aderhol/Clock_Synchronization/Interface/Hardware/measurements/PPS delay/50 Ohm driver/board#1/PPS feedback/pictures/P1140020.JPG

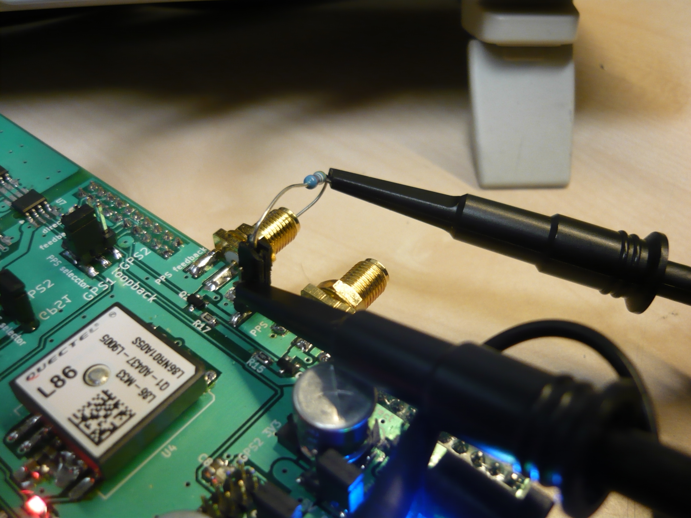
Interface/Hardware/measurements/PPS delay/50 Ohm driver/board#1/PPS feedback/pictures/P1140020.JPG
