aderhol/Clock_Synchronization/Interface/Hardware/BOM/BOM_Farnell.pdf

Date: | October 7, 2017
Component Count: | 6
Amount | Designation | Value | Package | Farnell | Datasheet
2 | isolator | ISO7421E | SOIC-8 | 2496656 http://www.ti.com/lit/ds/symlink/iso7421e.pdf
2 | RS-485 driver | SN65LBC179A | SOIC-8 | 1102962 http://www.ti.com/lit/ds/symlink/sn65lbc179a.pdf
1 | DC/DC converter NXJ1S0505MC | SMD | 2518531 http://power.murata.com/data/power/ncl/kdc_nxj1.pdf
1 | 8P8C connector | shield | SMD | 2533494 https://www.amphenolcanada.com/PDFjs/web/Viewer.html?file=../../ProductSearch/Drawings/AC/RJCSE538001.pdf
