aderhol/Clock_Synchronization/Interface/Hardware/Assembly/assembly record.xlsx

Sheet: card #1
reference | designation | value | date of mounting | note | auxiliary
C1 | capacitor | 0.1u | 2017-11-15
C2 | capacitor | 1000u | 2017-11-15
C3 | capacitor | 0.47u | 2017-11-14
C4 | capacitor | 22u | 2017-11-14
C5 | capacitor | 1000u | 2017-11-14
C8 | capacitor | 1u | 2017-11-14
C9 | capacitor | 0.1u | 2017-11-15
C10 | capacitor | 0.01u | 2017-11-15
C11 | capacitor | 1u | 2017-11-15
C12 | capacitor | 0.1u | 2017-11-15
C13 | capacitor | 0.1u | 2017-11-15
C14 | capacitor | 1u | 2017-11-15
C15 | capacitor | 10u | 2017-11-15
C16 | capacitor | 4.7u | 2017-11-14
C17 | capacitor | 0.1u | 2017-11-14
C18 | capacitor | 0.1u | 2017-11-14
C19 | capacitor | 0.1u | 2017-11-14
C20 | capacitor | 0.1u | 2017-11-14
C21 | capacitor | 2.2u | 2017-11-14
C22 | capacitor | 0.1u | 2017-11-14
C23 | capacitor | 0.1u | 2017-11-14
D1 | LED | blue | 2017-11-14 | direct
D2 | LED | blue | 2017-11-14 | feedback
D3 | LED | green | 2017-11-14 | line Tx
D4 | LED | yellow | 2017-11-14 | line Rx
D5 | LED | green | 2017-11-14 | GPS1 Tx
D6 | LED | yellow | 2017-11-14 | GPS1 Rx
D7 | LED | green | 2017-11-14 | GPS2 Tx
D8 | LED | yellow | 2017-11-14 | GPS2 Rx
D9 | Schottky diode | 1A - 20V | 2017-11-14
D10 | Schottky diode | 1A - 20V | 2017-11-14
D11 | zener diode | 24V | 2017-11-14
D12 | LED | blue | 2017-11-14 | 5V
D13 | LED | red | 2017-11-14 | 3V3
D14 | LED | red | 2017-11-14 | GPS2 3V3
D15 | LED | red | 2017-11-14 | GPS1 3V3
D16 | zener diode | 5V1 | 2017-11-14
D17 | LED | blue | 2017-11-14 | 5V
J1 | molex connector | 4-pin | 2017-11-15 | I2C
J2 | molex connector | 4-pin | 2017-11-15 | line UART
J3 | molex connector | 4-pin | 2017-11-15 | GPS2 UART
J4 | molex connector | 4-pin | 2017-11-15 | GPS1 UART
J5 | pin header | 2P | 2017-11-14 | PPS direct probe point
J6 | pin header | 3P x 2 | 2017-11-15 | PPS selecctor
J7 | pin header | 2P | 2017-11-14 | PPS feedback probe point
J8 | pin header | 10P x 2 | 2017-11-14 | left bottom connector
J9 | pin header | 10P x 2 | 2017-11-14 | right bottom connector
J10 | power connector | barrel jack | 2017-11-14
J11 | pin header | 2P | 2017-11-14 | PWR probe point
J12 | pin header | 2P | 2017-11-14 | 5V probe point
J13 | pin header | 4P x 2 | 2017-11-15 | GPS2 connector
J14 | SMA connector |  | 2017-11-15 | PPS direct
J15 | SMA connector |  | 2017-11-15 | PPS feedback
J16 | pin header | 2P | 2017-11-14 | DC/DC in probe point
J17 | pin header | 2P | 2017-11-14 | 5V isolated
J18 | modular jack | 8P8C | 2017-11-15 | RJ45
J19 | pin header | 10P x 2 | 2017-11-14 | left top connector
J20 | pin header | 10P x 2 | 2017-11-14 | right top connector
JP1 | pin header | 3P | 2017-11-15 | GPS selector
JP2 | pin header | 2P | 2017-11-14 | 5V out measurement point
JP3 | pin header | 2P | 2017-11-14 | 3v3 in measurement point
JP4 | resistor | 0 | 2017-11-15 | A0
JP5 | resistor | 0 | 2017-11-15 | A1
JP6 | pin header | 2P | 2017-11-14 | 5V in measurement point
JP7 | pin header | 3P | 2017-11-15 | GPS2 ant pwr
JP8 | pin header | 2P | 2017-11-14 | 5V isolated measurement point
JP9 | pin header | 2P | 2017-11-14 | DC/DC in measurement point
L1 | inductance | 4.7u | 2017-11-14
L2 | inductance | 10u | 2017-11-14
Q1 | pnp transistor | BSV52LT1G | 2017-11-15
Q2 | pnp transistor | BSV52LT1G | 2017-11-15
R1 | resistor | 2k | 2017-11-14
R2 | resistor | 2k | 2017-11-14
R3 | resistor | 390 | 2017-11-14
R4 | resistor | 390 | 2017-11-14
R5 | resistor | 10k | 2017-11-15
R6 | resistor | 2k | 2017-11-14
R7 | resistor | 10k | 2017-11-15
R8 | resistor | 2k | 2017-11-14
R9 | resistor | 10k | 2017-11-15
R10 | resistor | 2k | 2017-11-14
R11 | resistor | 2k | 2017-11-14
R12 | resistor | 1k5 | 2017-11-14
R13 | resistor | 1k5 | 2017-11-14
R14 | resistor | 1k5 | 2017-11-14
R15 | resistor | 50 | 2017-11-15
R16 | resistor | inf |  |  | X
R17 | resistor | 50 | 2017-11-15
R18 | resistor | inf |  |  | X
R19 | resistor | 0 - ??? | 2017-11-14 | 0
R20 | resistor | 100 | 2017-11-15
R21 | resistor | 100 | 2017-11-15
R22 | resistor | 2k | 2017-11-14
U1 | transistor array | ULN2003A | 2017-11-15
U2 | temperature sensor | LM92 | 2017-11-15
U3 | LDO regulator | LM2940S-5.0 | 2017-11-14
U4 | GPS | L86 | 2017-11-15 | GPS1
U5 | DC/DC converter | NXJ1S0505MC | 2017-11-14
U6 | digital isolator | ISO7421E | 2017-11-14
U7 | digital isolator | ISO7421E | 2017-11-14
U8 | RS-485 transceiver | SN65LBC179A | 2017-11-14
U9 | RS-485 transceiver | SN65LBC179A | 2017-11-14

Sheet: card #2
reference | designation | value | date of mounting | note | auxiliary
C1 | capacitor | 0.1u | 2017-11-17
C2 | capacitor | 1000u | 2017-11-17
C3 | capacitor | 0.47u | 2017-11-17
C4 | capacitor | 22u | 2017-11-17
C5 | capacitor | 1000u | 2017-11-17
C8 | capacitor | 1u | 2017-11-17
C9 | capacitor | 0.1u | 2017-11-16
C10 | capacitor | 0.01u | 2017-11-16
C11 | capacitor | 1u | 2017-11-16
C12 | capacitor | 0.1u | 2017-11-16
C13 | capacitor | 0.1u | 2017-11-21
C14 | capacitor | 1u | 2017-11-21
C15 | capacitor | 10u | 2027-11-21
C16 | capacitor | 4.7u | 2017-11-17
C17 | capacitor | 0.1u | 2017-11-17
C18 | capacitor | 0.1u | 2017-11-17
C19 | capacitor | 0.1u | 2017-11-17
C20 | capacitor | 0.1u | 2017-11-17
C21 | capacitor | 2.2u | 2017-11-17
C22 | capacitor | 0.1u | 2017-11-17
C23 | capacitor | 0.1u | 2017-11-17
D1 | LED | blue | 2017-11-17 | direct
D2 | LED | blue | 2017-11-17 | feedback
D3 | LED | green | 2017-11-17 | line Tx
D4 | LED | yellow | 2017-11-17 | line Rx
D5 | LED | green | 2017-11-17 | GPS1 Tx
D6 | LED | yellow | 2017-11-17 | GPS1 Rx
D7 | LED | green | 2017-11-17 | GPS2 Tx
D8 | LED | yellow | 2017-11-17 | GPS2 Rx
D9 | Schottky diode | 1A - 20V | 2017-11-17
D10 | Schottky diode | 1A - 20V | 2017-11-17
D11 | zener diode | 24V | 2017-11-17
D12 | LED | blue | 2017-11-17 | 5V
D13 | LED | red | 2017-11-17 | 3V3
D14 | LED | red | 2017-11-17 | GPS2 3V3
D15 | LED | red | 2017-11-21 | GPS1 3V3
D16 | zener diode | 5V1 | 2017-11-17
D17 | LED | blue | 2017-11-17 | 5V
J1 | molex connector | 4-pin | 2017-11-17 | I2C
J2 | molex connector | 4-pin | 2017-11-21 | line UART
J3 | molex connector | 4-pin | 2017-11-17 | GPS2 UART
J4 | molex connector | 4-pin | 2017-11-21 | GPS1 UART
J5 | pin header | 2P | 2017-11-17 | PPS direct probe point
J6 | pin header | 3P x 2 | 2017-11-17 | PPS selecctor
J7 | pin header | 2P | 2017-11-21 | PPS feedback probe point
J8 | pin header | 10P x 2 | 2017-11-17 | left bottom connector
J9 | pin header | 10P x 2 | 2017-11-17 | right bottom connector
J10 | power connector | barrel jack | 2017-11-17
J11 | pin header | 2P | 2017-11-17 | PWR probe point
J12 | pin header | 2P | 2017-11-17 | 5V probe point
J13 | pin header | 4P x 2 | 2017-11-17 | GPS2 connector
J14 | SMA connector |  | 2017-11-17 | PPS direct
J15 | SMA connector |  | 2017-11-21 | PPS feedback
J16 | pin header | 2P | 2017-11-17 | DC/DC in probe point
J17 | pin header | 2P | 2017-11-17 | 5V isolated
J18 | modular jack | 8P8C | 2017-11-17 | RJ45
J19 | pin header | 10P x 2 | 2017-11-17 | left top connector
J20 | pin header | 10P x 2 | 2017-11-17 | right top connector
JP1 | pin header | 3P | 2017-11-17 | GPS selector
JP2 | pin header | 2P | 2017-11-17 | 5V out measurement point
JP3 | pin header | 2P | 2017-11-17 | 3v3 in measurement point
JP4 | resistor | 0 | 2017-11-17 | A0
JP5 | resistor | 0 | 2017-11-17 | A1
JP6 | pin header | 2P | 2017-11-17 | 5V in measurement point
JP7 | pin header | 3P | 2017-11-17 | GPS2 ant pwr
JP8 | pin header | 2P | 2017-11-17 | 5V isolated measurement point
JP9 | pin header | 2P | 2017-11-17 | DC/DC in measurement point
L1 | inductance | 4.7u | 2017-11-17
L2 | inductance | 10u | 2017-11-17
Q1 | pnp transistor | BSV52LT1G | 2017-11-17
Q2 | pnp transistor | BSV52LT1G | 2017-11-21
R1 | resistor | 2k | 2017-11-17
R2 | resistor | 2k | 2017-11-17
R3 | resistor | 390 | 2017-11-17
R4 | resistor | 390 | 2017-11-17
R5 | resistor | 10k | 2017-11-16
R6 | resistor | 2k | 2017-11-16
R7 | resistor | 10k | 2017-11-16
R8 | resistor | 2k | 2017-11-16
R9 | resistor | 10k | 2017-11-16
R10 | resistor | 2k | 2017-11-16
R11 | resistor | 2k | 2017-11-16
R12 | resistor | 1k5 | 2017-11-17
R13 | resistor | 1k5 | 2017-11-16
R14 | resistor | 1k5 | 2017-11-17
R15 | resistor | 50 | 2017-11-17
R16 | resistor | inf |  |  | X
R17 | resistor | 50 | 2017-11-21 | 47ohm
R18 | resistor | inf |  |  | X
R19 | resistor | 0 - ??? | 2017-11-17 | 0
R20 | resistor | 100 | 2017-11-17
R21 | resistor | 100 | 2017-11-17
R22 | resistor | 2k | 2017-11-17
U1 | transistor array | ULN2003A | 2017-11-16
U2 | temperature sensor | LM92 | 2017-11-17
U3 | LDO regulator | LM2940S-5.0 | 2017-11-17
U4 | GPS | L86 | 2017-11-21 | GPS1
U5 | DC/DC converter | NXJ1S0505MC | 2017-11-17
U6 | digital isolator | ISO7421E | 2017-11-17
U7 | digital isolator | ISO7421E | 2017-11-17
U8 | RS-485 transceiver | SN65LBC179A | 2017-11-17
U9 | RS-485 transceiver | SN65LBC179A | 2017-11-17
