aderhol/Clock_Synchronization/Interface/Hardware/RS-422 Options/RS-422 interface options.xlsx

Sheet: transceivers
part number | isolated | temperature range | supply voltage | driver propagation delay typical | driver propagation delay maximum | receiver propagation delay typical | receiver propagation delay maximum | maximum driver propagation delay deviance over -40 °C to 85 °C | maximum receiver propagation delay deviance over -40 °C to 85°C | propagation delay asymmetry based on the typical values | price
ISO3086T | yes | -40 °C to +85 °C | 5V (3.3V) | 25 ns | 45 ns | 103 ns | 125 ns | 5.5 ns | 3.25 ns | 78 ns | 2659 Ft
SN65LBC179A | no | -40 °C to +85 °C | 5V | 6 ns | 12 ns | 13 ns | 20 ns | 1.0 ns | 0.53 ns | 7 ns | 897 Ft
ADM2582E | yes | -40 °C to +85 °C | 5V | 64 ns | 100 ns | 95 ns | 110 ns | 11.0 ns | NDA | 31 ns | 4495 Ft
LTM2881 | yes | -40 °C to +85 °C | 3.3V/5V | 60 ns | 85 ns | 100 ns | 140 ns | 6.0 ns | 10.0 ns | 40 ns | 4758 Ft
MAX14855 | yes | -40 °C to +105 °C | 3.3V/5V | 45 ns | 65 ns | 40 ns | 65 ns | 9.0 ns | 6.0 ns | 5 ns | 1685 Ft
ISO35T | yes | -40 °C to +85 °C | 3.3V | 205 ns | 340 ns | 85 ns | 115 ns | 28.0 ns | 20.0 ns | 120 ns | 2461 Ft
ISO35 | yes | -40 °C to +85 °C | 3.3V | NDA | 340 ns | NDA | 100 ns | NDA | NDA | NDA | 2461 Ft

Sheet: compact
part number | quantity | driver propagation delay typical | driver propagation delay maximum | receiver propagation delay typical | receiver propagation delay maximum | maximum driver propagation delay deviance over -40 °C to 85 °C | maximum receiver propagation delay deviance over -40 °C to 85°C | propagation delay asymmetry based on the typical values | price
ISO3086T | 2 pcs | 25 ns | 45 ns | 103 ns | 125 ns | 5.5 ns | 3.25 ns | 78 ns | 2659 Ft
DA2303-AL | 1 pcs |  |  |  |  |  |  |  | 809 Ft
TPS76350 | 1 pcs |  |  |  |  |  |  |  | 260 Ft
10 µF | 2 pcs |  |  |  |  |  |  |  | 50 Ft
4.7 µF | 1 pcs |  |  |  |  |  |  |  | 26 Ft
Schottky diode | 2 pcs |  |  |  |  |  |  |  | 17 Ft
0.1 µF | 5 pcs |  |  |  |  |  |  |  | 3 Ft
7 types | 14 pcs | 25 ns | 45 ns | 103 ns | 125 ns | 5.5 ns | 3.25 ns | 78 ns | 6562 Ft

Sheet: separate
part number | quantity | driver propagation delay typical | driver propagation delay maximum | receiver propagation delay typical | receiver propagation delay maximum | maximum driver propagation delay deviance over -40 °C to 85 °C | maximum receiver propagation delay deviance over -40 °C to 85°C | propagation delay asymmetry based on the typical values | price
SN65LBC179A | 2 pcs | 6 ns | 12 ns | 13 ns | 20 ns | 1.0 ns | 0.53 ns | 7 ns | 897 Ft
ISO7421E | 2 pcs | 7 ns | 11 ns | 7 ns | 11 ns | 0.75 ns | 0.75 ns | 0 ns | 1310 Ft
NXJ1S0505MC | 1 pcs |  |  |  |  |  |  |  | 897 Ft
LBR2518T100K | 1 pcs |  |  |  |  |  |  |  | 62 Ft
2.2 µF | 1 pcs |  |  |  |  |  |  |  | 27 Ft
CVH252009-4R7M | 1 pcs |  |  |  |  |  |  |  | 75 Ft
4.7 µF | 1 pcs |  |  |  |  |  |  |  | 26 Ft
0.1 µF | 6 pcs |  |  |  |  |  |  |  | 3 Ft
8 types | 15 pcs | 13 ns | 23 ns | 20 ns | 31 ns | 1.75 ns | 1.27 ns | 7 ns | 5519 Ft
