aderhol/Clock_Synchronization/Interface/Hardware/measurements/PPS delay/board-to-board/117cm/loopback/II/NOTE.txt

PPS direct: outgoing PPS from the module
PPS received: incoming PPS on the other module
PPS feedback: incoming PPS from the other module on the module which generates the PPS
