aderhol/Clock_Synchronization/Interface/Hardware/measurements/PPS delay/board-to-board/117cm/loopback/I/scope.CSV

Model | DPO2012
Firmware Version | 1.56
Point Format | Y
Horizontal Units | S
Horizontal Scale | 1e-05
Sample Interval | 1e-09
Filter Frequency | 1e+08
Record Length | 100000
Gating | 0.0% to 100.0% | 0.0% to 100.0%
Probe Attenuation | 10 | 10
Vertical Units | V | V
Vertical Offset | 0 | 0
Vertical Scale | 1 | 1
Label | PPS direct | PPS feedback
TIME | CH1 | CH2
-4.99580e-05 | 0.04 | 0.06
-4.99570e-05 | 0.04 | 0.06
-4.99560e-05 | 0.08 | 0.02
-4.99550e-05 | 0.08 | 0.02
-4.99540e-05 | 0.08 | 0.02
-4.99530e-05 | 0.04 | 0.02
-4.99520e-05 | 0.04 | 0.02
-4.99510e-05 | 0.04 | 0.06
-4.99500e-05 | 0.08 | 0.06
-4.99490e-05 | 0.08 | 0.1
-4.99480e-05 | 0.08 | 0.1
-4.99470e-05 | 0.08 | 0.06
-4.99460e-05 | 0.08 | 0.02
-4.99450e-05 | 0.08 | 0.02
-4.99440e-05 | 0.08 | 0.02
-4.99430e-05 | 0.04 | 0.02
-4.99420e-05 | 0.04 | 0.02
-4.99410e-05 | 0.04 | 0.02
-4.99400e-05 | 0.04 | 0.02
-4.99390e-05 | 0.04 | 0.06
-4.99380e-05 | 0.08 | 0.06
-4.99370e-05 | 0.08 | 0.1
-4.99360e-05 | 0.08 | 0.06
-4.99350e-05 | 0.08 | 0.02
-4.99340e-05 | 0.08 | 0.02
-4.99330e-05 | 0.04 | 0.02
-4.99320e-05 | 0.04 | -0.02
-4.99310e-05 | 0.04 | 0.02
-4.99300e-05 | 0.04 | 0.02
-4.99290e-05 | 0.04 | 0.06
-4.99280e-05 | 0.08 | 0.06
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
