aderhol/Clock_Synchronization/Interface/Hardware/measurements/PPS delay/board-to-board/MIT 03.104-03.105/board-to-board/sender-to-receiver/PicoScope waveforms/PicoScope_01.csv

Time | Channel A | Channel B
(ns) | (V) | (V)
-51.54300531 | 0.00153789 | -0.00030758
-51.29300531 | 0.00369095 | -0.00338337
-51.04300532 | 0.00476747 | -0.00891978
-50.79300533 | 0.00538263 | -0.01599409
-50.54300534 | 0.00538263 | -0.02352977
-50.29300534 | 0.00476747 | -0.03060408
-50.04300535 | 0.00353716 | -0.03598671
-49.79300536 | 0.00138410 | -0.03890871
-49.54300536 | -0.00169168 | -0.03890871
-49.29300537 | -0.00584400 | -0.03598671
-49.04300538 | -0.01107283 | -0.03060408
-48.79300539 | -0.01676304 | -0.02352977
-48.54300539 | -0.02276083 | -0.01599409
-48.29300540 | -0.02845103 | -0.00891978
-48.04300541 | -0.03352608 | -0.00338337
-47.79300541 | -0.03752461 | -0.00030758
-47.54300542 | -0.04060039 | -0.00030758
-47.29300543 | -0.04229207 | -0.00338337
-47.04300543 | -0.04290723 | -0.00891978
-46.79300544 | -0.04259966 | -0.01599409
-46.54300545 | -0.04183071 | -0.02352977
-46.29300546 | -0.04075418 | -0.03060408
-46.04300546 | -0.03983144 | -0.03583292
-45.79300547 | -0.03937008 | -0.03875492
-45.54300548 | -0.03921629 | -0.03890871
-45.29300548 | -0.03921629 | -0.03660187
-45.04300549 | -0.03937008 | -0.03183440
-44.79300550 | -0.03952387 | -0.02583661
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
