aderhol/Clock_Synchronization/Interface/Hardware/measurements/PPS delay/board-to-board/MIT 03.104-03.105/board-to-board/sender-to-receiver/PicoScope waveforms/PicoScope_02.csv

Time | Channel A | Channel B
(ns) | (V) | (V)
-50.27534231 | 0.00000000 | 0.00153789
-50.02534231 | 0.00046137 | 0.00369095
-49.77534232 | 0.00123032 | 0.00476747
-49.52534233 | 0.00230684 | 0.00538263
-49.27534234 | 0.00307579 | 0.00538263
-49.02534234 | 0.00338337 | 0.00476747
-48.77534235 | 0.00292200 | 0.00369095
-48.52534236 | 0.00138410 | 0.00153789
-48.27534236 | -0.00169168 | -0.00184547
-48.02534237 | -0.00584400 | -0.00645915
-47.77534238 | -0.01091904 | -0.01230315
-47.52534239 | -0.01676304 | -0.01906988
-47.27534239 | -0.02276083 | -0.02583661
-47.02534240 | -0.02845103 | -0.03183440
-46.77534241 | -0.03352608 | -0.03660187
-46.52534241 | -0.03752461 | -0.03890871
-46.27534242 | -0.04060039 | -0.03875492
-46.02534243 | -0.04229207 | -0.03583292
-45.77534243 | -0.04290723 | -0.03060408
-45.52534244 | -0.04259966 | -0.02352977
-45.27534245 | -0.04183071 | -0.01599409
-45.02534246 | -0.04075418 | -0.00891978
-44.77534246 | -0.03983144 | -0.00338337
-44.52534247 | -0.03921629 | -0.00030758
-44.27534248 | -0.03921629 | -0.00030758
-44.02534248 | -0.03983144 | -0.00338337
-43.77534249 | -0.04075418 | -0.00891978
-43.52534250 | -0.04183071 | -0.01599409
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
