aderhol/Clock_Synchronization/Interface/Hardware/measurements/PPS delay/board-to-board/MIT 03.104-03.105/board-to-board/sender-to-receiver/PicoScope waveforms/PicoScope_03.csv

Time | Channel A | Channel B
(ns) | (V) | (V)
-51.15078131 | 0.00000000 | 0.00000000
-50.90078131 | 0.00000000 | 0.00000000
-50.65078132 | 0.00000000 | 0.00000000
-50.40078133 | 0.00000000 | 0.00000000
-50.15078134 | 0.00000000 | 0.00000000
-49.90078134 | 0.00000000 | 0.00000000
-49.65078135 | 0.00000000 | 0.00000000
-49.40078136 | 0.00000000 | 0.00000000
-49.15078136 | 0.00000000 | 0.00000000
-48.90078137 | 0.00000000 | 0.00000000
-48.65078138 | 0.00000000 | 0.00000000
-48.40078139 | 0.00000000 | 0.00000000
-48.15078139 | 0.00000000 | 0.00000000
-47.90078140 | 0.00000000 | 0.00000000
-47.65078141 | 0.00000000 | 0.00000000
-47.40078141 | 0.00000000 | 0.00000000
-47.15078142 | 0.00000000 | 0.00000000
-46.90078143 | 0.00000000 | 0.00000000
-46.65078143 | 0.00000000 | 0.00000000
-46.40078144 | 0.00000000 | 0.00000000
-46.15078145 | 0.00000000 | 0.00000000
-45.90078146 | 0.00000000 | 0.00000000
-45.65078146 | 0.00000000 | 0.00000000
-45.40078147 | 0.00000000 | 0.00000000
-45.15078148 | 0.00000000 | 0.00000000
-44.90078148 | 0.00000000 | 0.00000000
-44.65078149 | 0.00000000 | 0.00000000
-44.40078150 | 0.00000000 | 0.00000000
-44.15078151 | 0.00000000 | 0.00000000
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
