aderhol/Clock_Synchronization/Interface/Hardware/measurements/PPS delay/board-to-board/MIT 03.104-03.105/board-to-board/sender-to-receiver/PicoScope waveforms/PicoScope_04.csv

Time | Channel A | Channel B
(ns) | (V) | (V)
-51.70739431 | 0.00000000 | -0.00046137
-51.45739431 | 0.00000000 | -0.00338337
-51.20739432 | 0.00000000 | -0.00891978
-50.95739433 | 0.00000000 | -0.01599409
-50.70739434 | 0.00000000 | -0.02352977
-50.45739434 | 0.00000000 | -0.03060408
-50.20739435 | 0.00000000 | -0.03598671
-49.95739436 | 0.00000000 | -0.03890871
-49.70739436 | 0.00000000 | -0.03890871
-49.45739437 | 0.00000000 | -0.03598671
-49.20739438 | 0.00000000 | -0.03060408
-48.95739439 | 0.00000000 | -0.02352977
-48.70739439 | 0.00000000 | -0.01599409
-48.45739440 | 0.00000000 | -0.00891978
-48.20739441 | -0.00015379 | -0.00338337
-47.95739441 | 0.00000000 | -0.00030758
-47.70739442 | 0.00015379 | -0.00030758
-47.45739443 | 0.00061516 | -0.00338337
-47.20739443 | 0.00138410 | -0.00891978
-46.95739444 | 0.00230684 | -0.01599409
-46.70739445 | 0.00307579 | -0.02352977
-46.45739446 | 0.00353716 | -0.03060408
-46.20739446 | 0.00307579 | -0.03583292
-45.95739447 | 0.00138410 | -0.03875492
-45.70739448 | -0.00169168 | -0.03890871
-45.45739448 | -0.00645915 | -0.03660187
-45.20739449 | -0.01230315 | -0.03183440
-44.95739450 | -0.01906988 | -0.02583661
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
