aderhol/Clock_Synchronization/Interface/Hardware/measurements/PPS delay/board-to-board/MIT 03.104-03.105/board-to-board/sender-to-receiver/PicoScope waveforms/PicoScope_05.csv

Time | Channel A | Channel B
(ns) | (V) | (V)
-51.53545431 | 0.00000000 | -0.03890871
-51.28545431 | 0.00000000 | -0.03660187
-51.03545432 | 0.00000000 | -0.03183440
-50.78545433 | 0.00000000 | -0.02583661
-50.53545434 | 0.00000000 | -0.01906988
-50.28545434 | 0.00000000 | -0.01230315
-50.03545435 | 0.00000000 | -0.00645915
-49.78545436 | 0.00000000 | -0.00169168
-49.53545436 | 0.00000000 | 0.00138410
-49.28545437 | 0.00000000 | 0.00307579
-49.03545438 | 0.00000000 | 0.00353716
-48.78545439 | 0.00000000 | 0.00307579
-48.53545439 | 0.00000000 | 0.00230684
-48.28545440 | 0.00000000 | 0.00138410
-48.03545441 | 0.00000000 | 0.00061516
-47.78545441 | 0.00000000 | 0.00015379
-47.53545442 | 0.00000000 | 0.00000000
-47.28545443 | 0.00000000 | -0.00015379
-47.03545443 | 0.00000000 | 0.00000000
-46.78545444 | 0.00000000 | 0.00000000
-46.53545445 | 0.00000000 | 0.00000000
-46.28545446 | 0.00000000 | 0.00000000
-46.03545446 | 0.00000000 | 0.00000000
-45.78545447 | 0.00000000 | 0.00000000
-45.53545448 | 0.00000000 | 0.00000000
-45.28545448 | 0.00000000 | 0.00000000
-45.03545449 | 0.00000000 | 0.00000000
-44.78545450 | 0.00000000 | 0.00000000
-44.53545451 | 0.00000000 | 0.00000000
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
