aderhol/Clock_Synchronization/Interface/Hardware/measurements/PPS delay/board-to-board/MIT 03.104-03.105/board-to-board/sender-to-receiver/PicoScope waveforms/PicoScope_06.csv

Time | Channel A | Channel B
(ns) | (V) | (V)
-50.99566831 | 0.00000000 | -0.03890871
-50.74566831 | -0.00015379 | -0.03598671
-50.49566832 | 0.00000000 | -0.03060408
-50.24566833 | 0.00000000 | -0.02352977
-49.99566834 | 0.00000000 | -0.01599409
-49.74566834 | 0.00000000 | -0.00891978
-49.49566835 | 0.00000000 | -0.00338337
-49.24566836 | 0.00000000 | -0.00030758
-48.99566836 | 0.00000000 | -0.00030758
-48.74566837 | 0.00000000 | -0.00338337
-48.49566838 | 0.00000000 | -0.00891978
-48.24566839 | 0.00000000 | -0.01599409
-47.99566839 | 0.00000000 | -0.02352977
-47.74566840 | 0.00000000 | -0.03060408
-47.49566841 | -0.00015379 | -0.03598671
-47.24566841 | 0.00000000 | -0.03890871
-46.99566842 | 0.00015379 | -0.03890871
-46.74566843 | 0.00061516 | -0.03598671
-46.49566843 | 0.00138410 | -0.03060408
-46.24566844 | 0.00230684 | -0.02352977
-45.99566845 | 0.00307579 | -0.01599409
-45.74566846 | 0.00353716 | -0.00891978
-45.49566846 | 0.00307579 | -0.00338337
-45.24566847 | 0.00138410 | -0.00030758
-44.99566848 | -0.00169168 | -0.00030758
-44.74566848 | -0.00645915 | -0.00338337
-44.49566849 | -0.01230315 | -0.00891978
-44.24566850 | -0.01906988 | -0.01599409
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
