aderhol/Clock_Synchronization/Interface/Hardware/measurements/PPS delay/cable loopback/scope.CSV

Model | DPO2012
Firmware Version | 1.56
Point Format | Y
Horizontal Units | S
Horizontal Scale | 1e-05
Sample Interval | 1e-09
Filter Frequency | 1e+08
Record Length | 100000
Gating | 0.0% to 100.0% | 0.0% to 100.0%
Probe Attenuation | 10 | 10
Vertical Units | V | V
Vertical Offset | 0 | 0
Vertical Scale | 1 | 1
Label | PPS direct | PPS feedback
TIME | CH1 | CH2
-4.99800e-05 | 0.12 | 0.02
-4.99790e-05 | 0.08 | 0.06
-4.99780e-05 | 0.08 | 0.02
-4.99770e-05 | 0.04 | 0.02
-4.99760e-05 | 0.04 | 0.02
-4.99750e-05 | 0 | 0.02
-4.99740e-05 | 0.04 | 0.02
-4.99730e-05 | 0.04 | 0.06
-4.99720e-05 | 0.12 | 0.06
-4.99710e-05 | 0.12 | 0.06
-4.99700e-05 | 0.12 | 0.06
-4.99690e-05 | 0.08 | 0.06
-4.99680e-05 | 0.04 | 0.06
-4.99670e-05 | 0 | 0.02
-4.99660e-05 | 0 | 0.02
-4.99650e-05 | 0 | 0.02
-4.99640e-05 | 0.04 | 0.02
-4.99630e-05 | 0.08 | 0.06
-4.99620e-05 | 0.12 | 0.06
-4.99610e-05 | 0.12 | 0.06
-4.99600e-05 | 0.12 | 0.06
-4.99590e-05 | 0.08 | 0.1
-4.99580e-05 | 0.04 | 0.02
-4.99570e-05 | 0 | 0.02
-4.99560e-05 | 0 | 0.02
-4.99550e-05 | 0 | 0.02
-4.99540e-05 | 0.04 | 0.02
-4.99530e-05 | 0.08 | 0.02
-4.99520e-05 | 0.12 | 0.02
-4.99510e-05 | 0.12 | 0.06
-4.99500e-05 | 0.12 | 0.06
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
