aderhol/Clock_Synchronization/Interface/Hardware/measurements/PPS delay/50 Ohm driver/board#1/PPS feedback/T0000ALL.CSV

Model | DPO2012
Firmware Version | 1.56
Point Format | Y
Horizontal Units | S
Horizontal Scale | 1e-05
Sample Interval | 1e-09
Filter Frequency | 1e+08
Record Length | 100000
Gating | 0.0% to 100.0% | 0.0% to 100.0%
Probe Attenuation | 10 | 10
Vertical Units | V | V
Vertical Offset | 0 | 0
Vertical Scale | 0.5 | 0.5
Label | PPS feedback | 50 \x11
TIME | CH1 | CH2
-4.99880e-05 | 0.02 | 0.00999999
-4.99870e-05 | 0.02 | 0.00999999
-4.99860e-05 | 0.04 | 0.00999999
-4.99850e-05 | 0.04 | 0.03
-4.99840e-05 | 0.06 | 0.03
-4.99830e-05 | 0.04 | 0.03
-4.99820e-05 | 0.06 | 0.03
-4.99810e-05 | 0.02 | 0.05
-4.99800e-05 | 0.02 | 0.03
-4.99790e-05 | 0 | 0.03
-4.99780e-05 | 0 | 0.00999999
-4.99770e-05 | -0.02 | 0.00999999
-4.99760e-05 | 0 | 0.00999999
-4.99750e-05 | 0.02 | 0.00999999
-4.99740e-05 | 0.06 | 0.00999999
-4.99730e-05 | 0.06 | 0.00999999
-4.99720e-05 | 0.06 | 0.00999999
-4.99710e-05 | 0.04 | 0.05
-4.99700e-05 | 0.02 | 0.03
-4.99690e-05 | 0 | 0.03
-4.99680e-05 | 0.02 | 0.00999999
-4.99670e-05 | -0.02 | 0.03
-4.99660e-05 | 0.02 | -0.01
-4.99650e-05 | 0.04 | 0.00999999
-4.99640e-05 | 0.06 | 0.00999999
-4.99630e-05 | 0.04 | 0.03
-4.99620e-05 | 0.04 | 0.03
-4.99610e-05 | 0.02 | 0.03
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
