aderhol/Clock_Synchronization/Interface/Hardware/measurements/PPS delay/board-to-board/1100cm/loopback/scope.CSV

Model | DPO2012
Firmware Version | 1.56
Point Format | Y
Horizontal Units | S
Horizontal Scale | 1e-05
Sample Interval | 1e-09
Filter Frequency | 1e+08
Record Length | 100000
Gating | 0.0% to 100.0% | 0.0% to 100.0%
Probe Attenuation | 10 | 10
Vertical Units | V | V
Vertical Offset | 0 | 0
Vertical Scale | 1 | 1
Label | PPS board#1 | PPS board#2
TIME | CH1 | CH2
-4.99076e-05 | 0.08 | 0.06
-4.99066e-05 | 0.08 | 0.06
-4.99056e-05 | 0.08 | 0.06
-4.99046e-05 | 0.08 | 0.06
-4.99036e-05 | 0.08 | 0.02
-4.99026e-05 | 0.08 | -0.02
-4.99016e-05 | 0.08 | -0.02
-4.99006e-05 | 0.04 | -0.02
-4.98996e-05 | 0.04 | -0.02
-4.98986e-05 | 0.04 | 0.06
-4.98976e-05 | 0.08 | 0.06
-4.98966e-05 | 0.08 | 0.1
-4.98956e-05 | 0.12 | 0.1
-4.98946e-05 | 0.12 | 0.06
-4.98936e-05 | 0.12 | 0.02
-4.98926e-05 | 0.08 | 0.02
-4.98916e-05 | 0.04 | -0.02
-4.98906e-05 | 0.04 | -0.02
-4.98896e-05 | 0.04 | -0.02
-4.98886e-05 | 0.04 | 0.02
-4.98876e-05 | 0.04 | 0.06
-4.98866e-05 | 0.08 | 0.1
-4.98856e-05 | 0.12 | 0.1
-4.98846e-05 | 0.12 | 0.06
-4.98836e-05 | 0.12 | 0.06
-4.98826e-05 | 0.08 | 0.02
-4.98816e-05 | 0.04 | -0.02
-4.98806e-05 | 0 | -0.06
-4.98796e-05 | 0 | -0.02
-4.98786e-05 | 0.04 | 0.02
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
