aderhol/Clock_Synchronization/Interface/Hardware/measurements/PPS delay/board-to-board/1100cm/board-to-board/sender-to-receiver/scope.CSV

Model | DPO2012
Firmware Version | 1.56
Point Format | Y
Horizontal Units | S
Horizontal Scale | 1e-05
Sample Interval | 1e-09
Filter Frequency | 1e+08
Record Length | 100000
Gating | 0.0% to 100.0% | 0.0% to 100.0%
Probe Attenuation | 10 | 10
Vertical Units | V | V
Vertical Offset | 0 | 0
Vertical Scale | 1 | 1
Label | PPS board#1 | PPS board#2
TIME | CH1 | CH2
-4.99534e-05 | 0.08 | 0.02
-4.99524e-05 | 0.04 | 0.02
-4.99514e-05 | 0.04 | 0.02
-4.99504e-05 | 0.04 | 0.02
-4.99494e-05 | 0.04 | 0.06
-4.99484e-05 | 0.04 | 0.06
-4.99474e-05 | 0.08 | 0.06
-4.99464e-05 | 0.08 | 0.06
-4.99454e-05 | 0.12 | 0.02
-4.99444e-05 | 0.08 | 0.02
-4.99434e-05 | 0.08 | -0.02
-4.99424e-05 | 0 | -0.02
-4.99414e-05 | 0 | -0.06
-4.99404e-05 | 0 | -0.02
-4.99394e-05 | 0.04 | 0.02
-4.99384e-05 | 0.08 | 0.06
-4.99374e-05 | 0.08 | 0.1
-4.99364e-05 | 0.12 | 0.1
-4.99354e-05 | 0.12 | 0.1
-4.99344e-05 | 0.12 | 0.06
-4.99334e-05 | 0.08 | -0.02
-4.99324e-05 | 0.04 | -0.06
-4.99314e-05 | 0.04 | -0.06
-4.99304e-05 | 0.04 | -0.02
-4.99294e-05 | 0.04 | 0.02
-4.99284e-05 | 0.08 | 0.1
-4.99274e-05 | 0.08 | 0.1
-4.99264e-05 | 0.08 | 0.1
-4.99254e-05 | 0.08 | 0.1
-4.99244e-05 | 0.08 | 0.06
-4.99234e-05 | 0.04 | -0.02
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
