aderhol/Clock_Synchronization/Interface/Hardware/measurements/PPS delay/board-to-board/117cm/board-to-board/sender-to-receiver/scope.CSV

Model | DPO2012
Firmware Version | 1.56
Point Format | Y
Horizontal Units | S
Horizontal Scale | 1e-05
Sample Interval | 1e-09
Filter Frequency | 1e+08
Record Length | 100000
Gating | 0.0% to 100.0% | 0.0% to 100.0%
Probe Attenuation | 10 | 10
Vertical Units | V | V
Vertical Offset | 0 | 0
Vertical Scale | 1 | 1
Label | PPS board#1 | PPS board#2
TIME | CH1 | CH2
-4.99778e-05 | 0.08 | 0.06
-4.99768e-05 | 0.04 | 0.06
-4.99758e-05 | 0.08 | 0.06
-4.99748e-05 | 0.08 | 0.1
-4.99738e-05 | 0.08 | 0.02
-4.99728e-05 | 0.04 | 0.02
-4.99718e-05 | 0.08 | -0.02
-4.99708e-05 | 0.04 | 0.02
-4.99698e-05 | 0.08 | 0.02
-4.99688e-05 | 0.04 | 0.06
-4.99678e-05 | 0.08 | 0.06
-4.99668e-05 | 0.04 | 0.1
-4.99658e-05 | 0.08 | 0.06
-4.99648e-05 | 0.04 | 0.02
-4.99638e-05 | 0.04 | 0.02
-4.99628e-05 | 0.04 | 0.02
-4.99618e-05 | 0.04 | 0.02
-4.99608e-05 | 0.04 | 0.02
-4.99598e-05 | 0.08 | 0.02
-4.99588e-05 | 0.08 | 0.06
-4.99578e-05 | 0.08 | 0.06
-4.99568e-05 | 0.04 | 0.06
-4.99558e-05 | 0.08 | 0.02
-4.99548e-05 | 0.04 | 0.06
-4.99538e-05 | 0.04 | 0.02
-4.99528e-05 | 0.04 | 0.02
-4.99518e-05 | 0.04 | -0.02
-4.99508e-05 | 0.04 | 0.02
-4.99498e-05 | 0.08 | 0.02
-4.99488e-05 | 0.04 | 0.06
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
