aderhol/Clock_Synchronization/Interface/Hardware/measurements/PPS delay/50 Ohm driver/board#1/PPS direct/pictures/P1140017.JPG

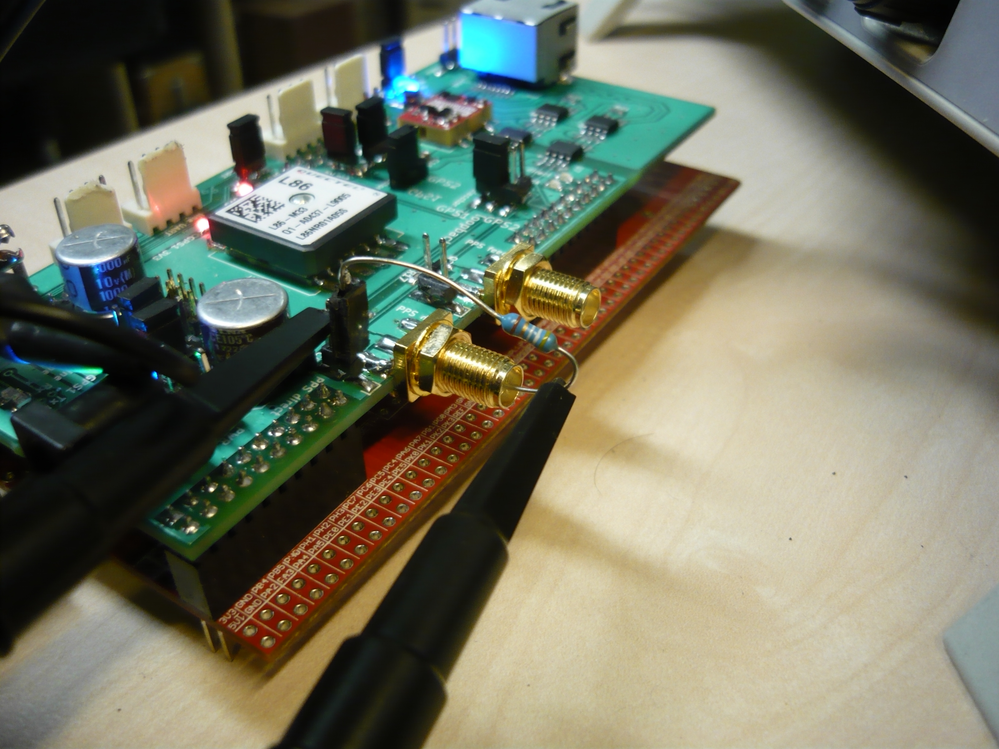
Interface/Hardware/measurements/PPS delay/50 Ohm driver/board#1/PPS direct/pictures/P1140017.JPG
