aderhol/Clock_Synchronization/Interface/Hardware/measurements/PPS delay/50 Ohm driver/board#1/PPS direct/tek00000.PNG

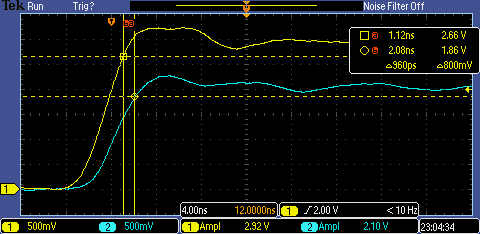
Interface/Hardware/measurements/PPS delay/50 Ohm driver/board#1/PPS direct/tek00000.PNG
