aderhol/Clock_Synchronization/Interface/Hardware/measurements/PPS delay/50 Ohm driver/board#2/PPS direct/pictures/P1140024.JPG

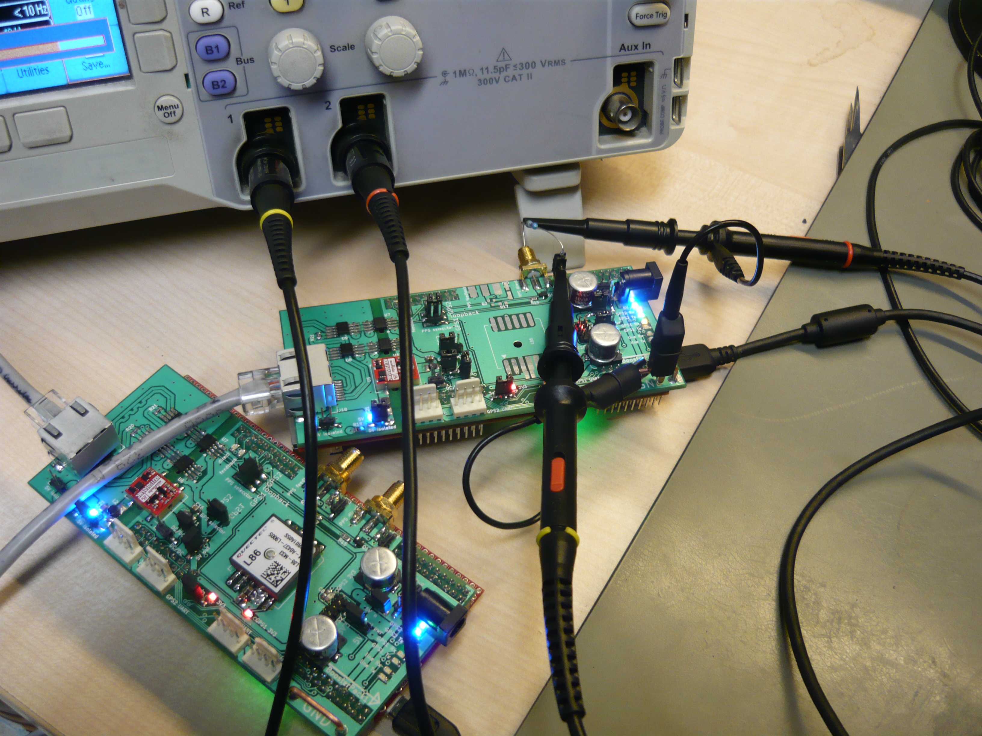
Interface/Hardware/measurements/PPS delay/50 Ohm driver/board#2/PPS direct/pictures/P1140024.JPG
