aderhol/Clock_Synchronization/Interface/Hardware/measurements/PPS delay/50 Ohm driver/board#2/PPS feedback/pictures/P1140066.JPG

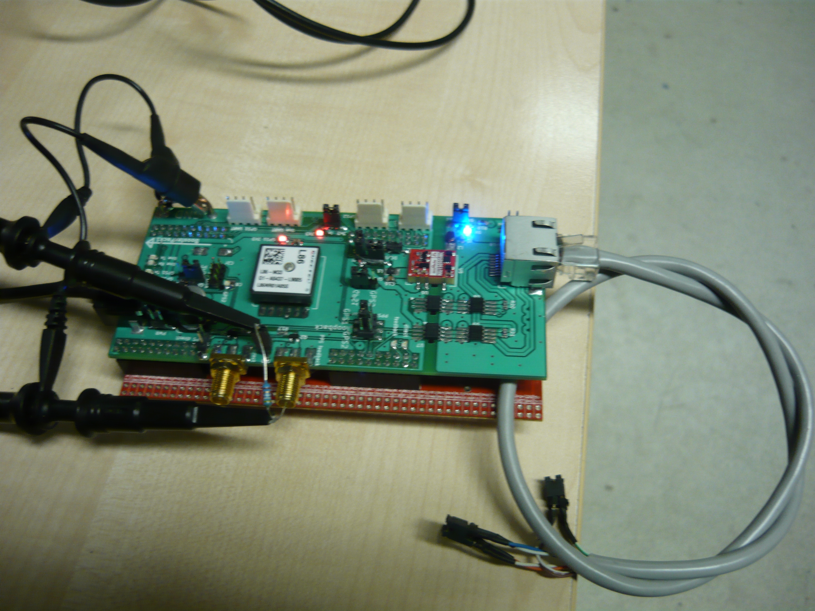
Interface/Hardware/measurements/PPS delay/50 Ohm driver/board#2/PPS feedback/pictures/P1140066.JPG
