aderhol/Clock_Synchronization/Interface/Hardware/measurements/PPS delay/50 Ohm driver/board#2/PPS feedback/TEK00000.PNG

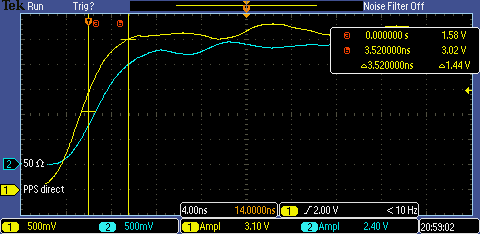
Interface/Hardware/measurements/PPS delay/50 Ohm driver/board#2/PPS feedback/TEK00000.PNG
