aderhol/Clock_Synchronization/Interface/Hardware/measurements/PPS delay/board-to-board/117cm/loopback/I/pictures/P1140004.JPG

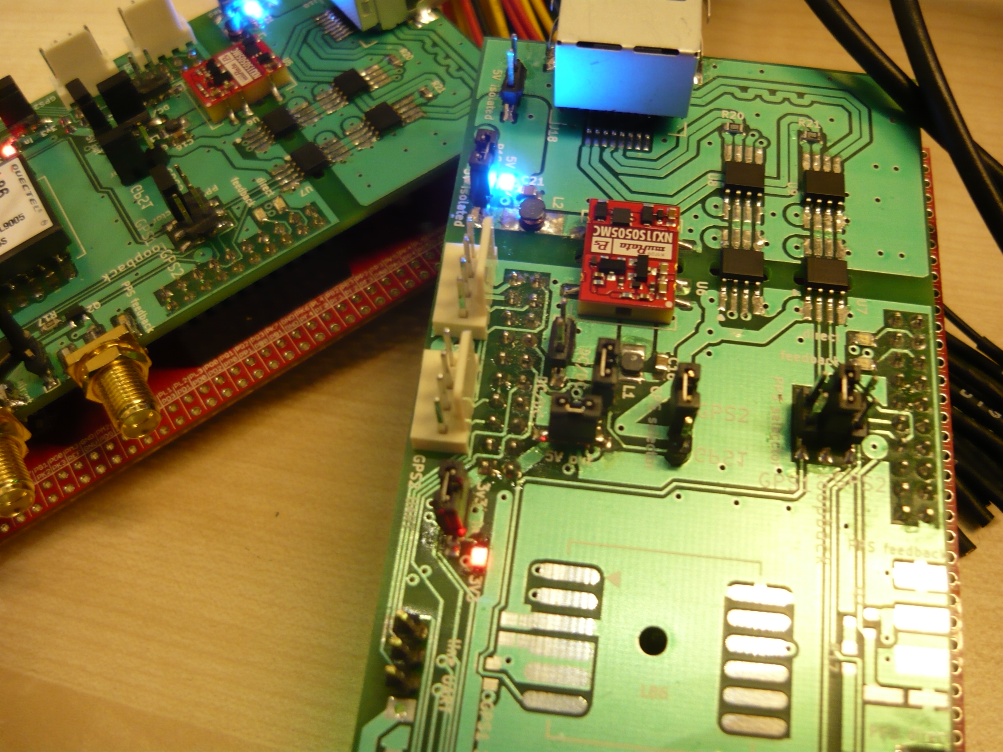
Interface/Hardware/measurements/PPS delay/board-to-board/117cm/loopback/I/pictures/P1140004.JPG
