aderhol/Clock_Synchronization/Interface/Hardware/measurements/PPS delay/board-to-board/117cm/loopback/I/scope.PNG

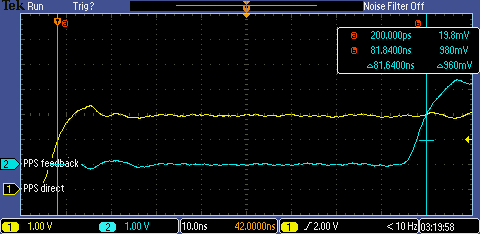
Interface/Hardware/measurements/PPS delay/board-to-board/117cm/loopback/I/scope.PNG
