aderhol/Clock_Synchronization/Interface/Hardware/measurements/PPS delay/board-to-board/117cm/loopback/I/VirtualBench.png

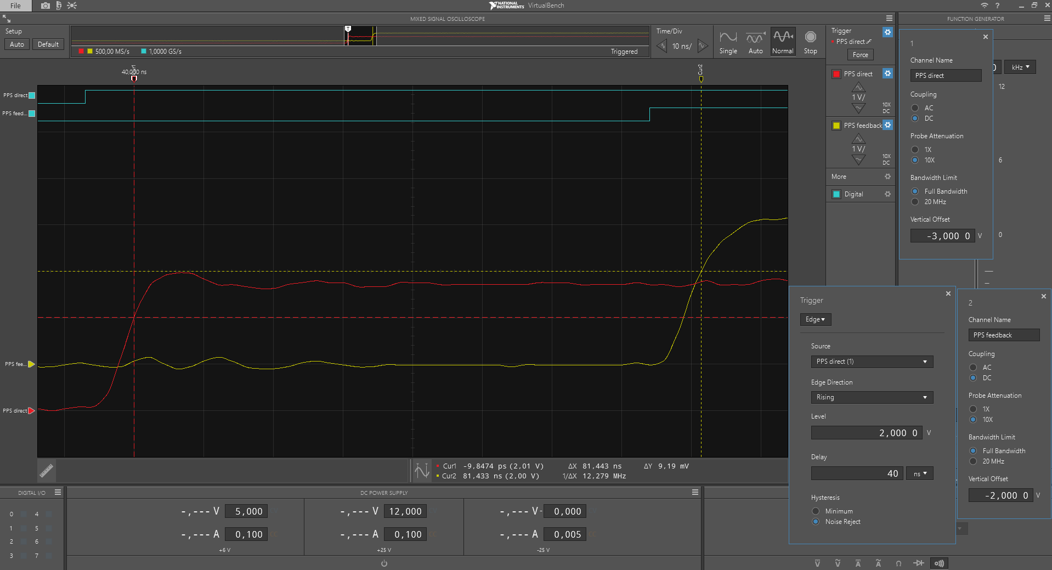
Interface/Hardware/measurements/PPS delay/board-to-board/117cm/loopback/I/VirtualBench.png
