aderhol/Clock_Synchronization/Interface/Hardware/measurements/PPS delay/board-to-board/117cm/loopback/II/30°C.png

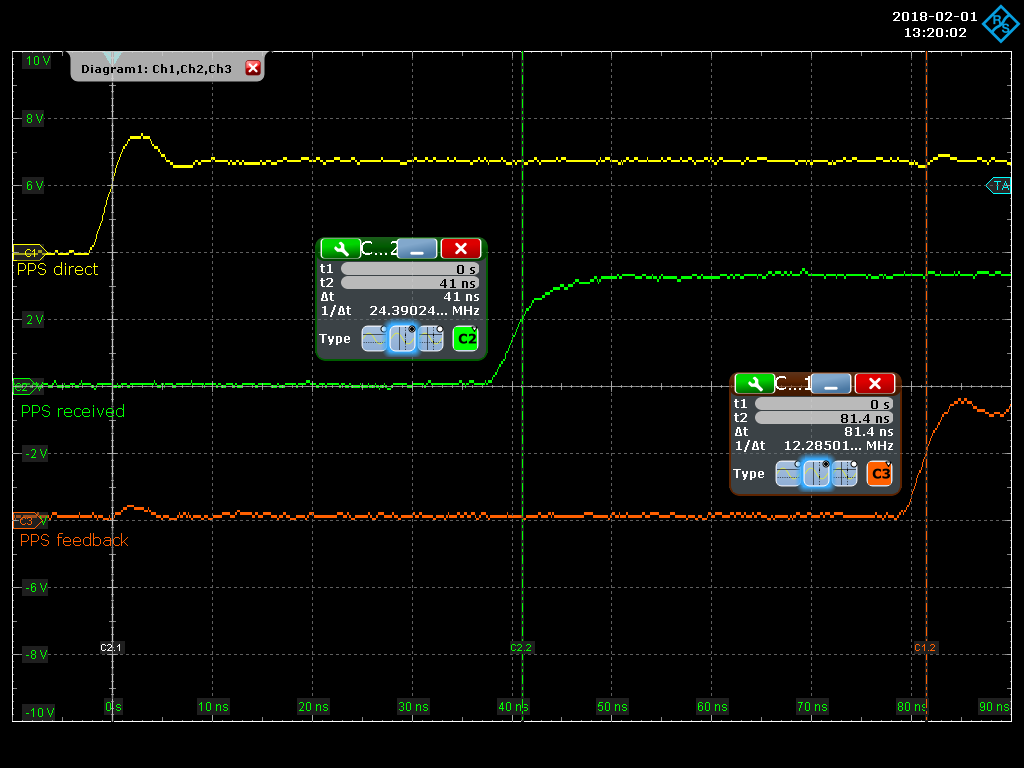
Interface/Hardware/measurements/PPS delay/board-to-board/117cm/loopback/II/30°C.png
