aderhol/Clock_Synchronization/Interface/Hardware/measurements/PPS delay/board-to-board/117cm/loopback/II/jitter (10 minutes).png

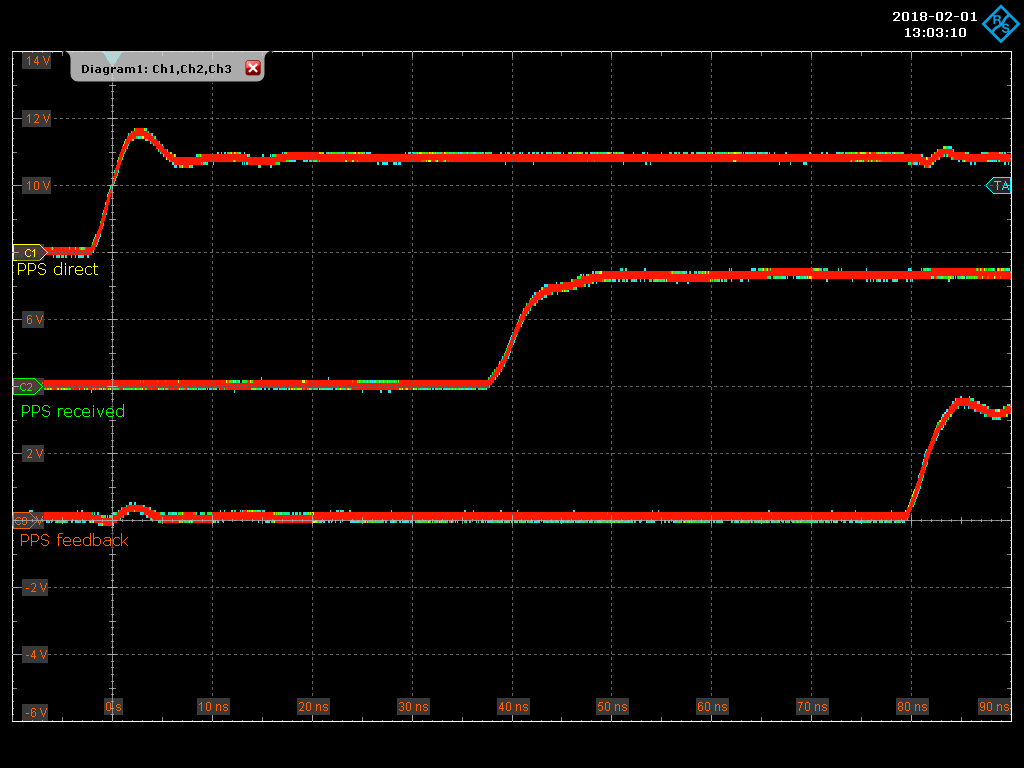
Interface/Hardware/measurements/PPS delay/board-to-board/117cm/loopback/II/jitter (10 minutes).png
