aderhol/Clock_Synchronization/Interface/Hardware/measurements/PPS delay/board-to-board/1100cm/loopback/pictures/P1140013.JPG

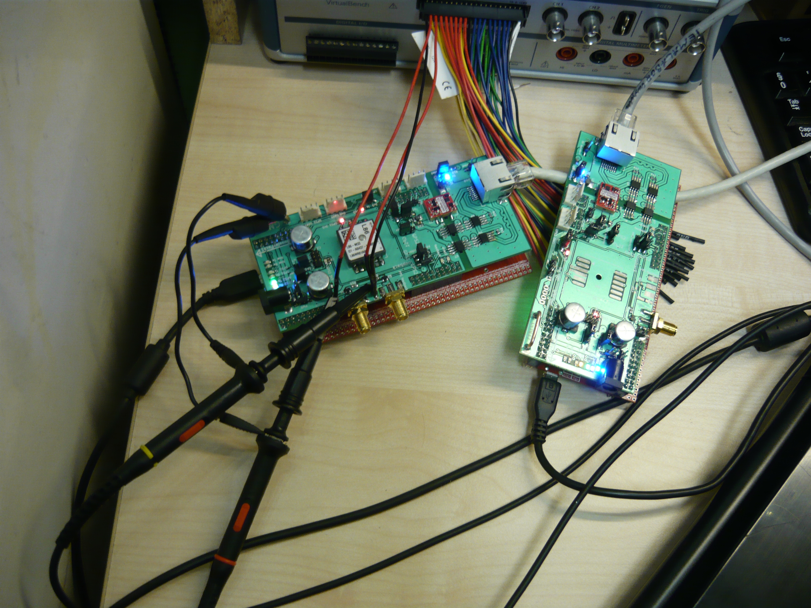
Interface/Hardware/measurements/PPS delay/board-to-board/1100cm/loopback/pictures/P1140013.JPG
