aderhol/Clock_Synchronization/Interface/Hardware/measurements/PPS delay/board-to-board/MIT 03.076-03.077/jitter (2 minutes).png

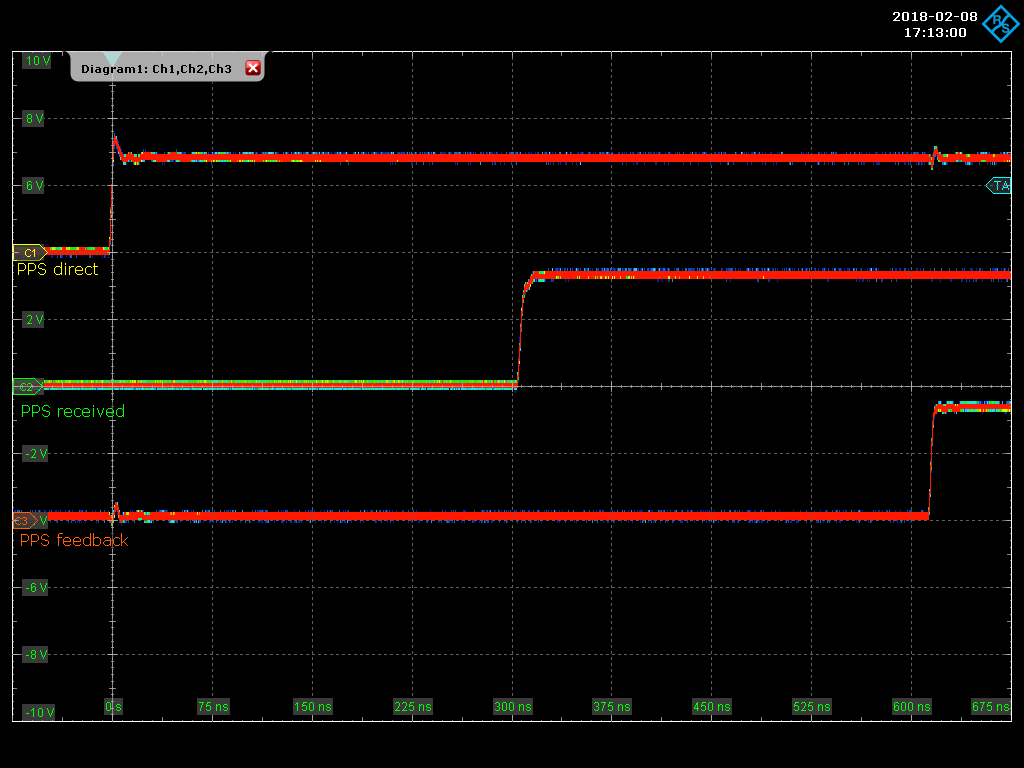
Interface/Hardware/measurements/PPS delay/board-to-board/MIT 03.076-03.077/jitter (2 minutes).png
