aderhol/Clock_Synchronization/Interface/Hardware/measurements/PPS delay/board-to-board/MIT 03.104-03.105/loopback/pictures/P1140027.JPG

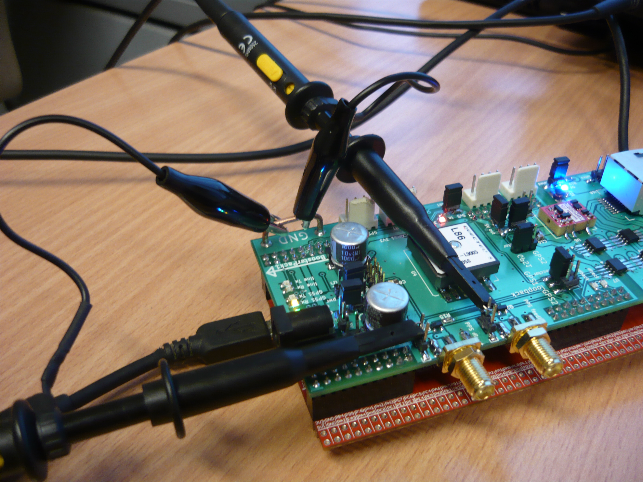
Interface/Hardware/measurements/PPS delay/board-to-board/MIT 03.104-03.105/loopback/pictures/P1140027.JPG
