aderhol/Clock_Synchronization/Interface/Hardware/measurements/PPS delay/cable loopback/pictures/P1130361.JPG

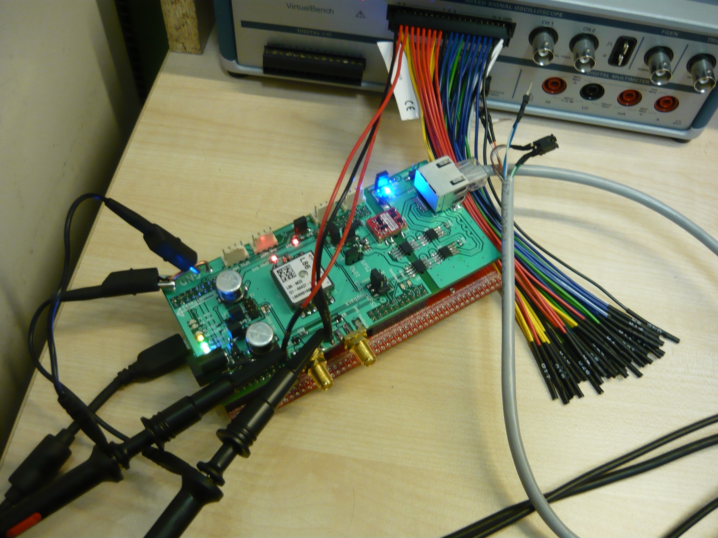
Interface/Hardware/measurements/PPS delay/cable loopback/pictures/P1130361.JPG
