aderhol/Clock_Synchronization/Interface/Hardware/measurements/PPS delay/cable loopback/pictures/P1130362.JPG

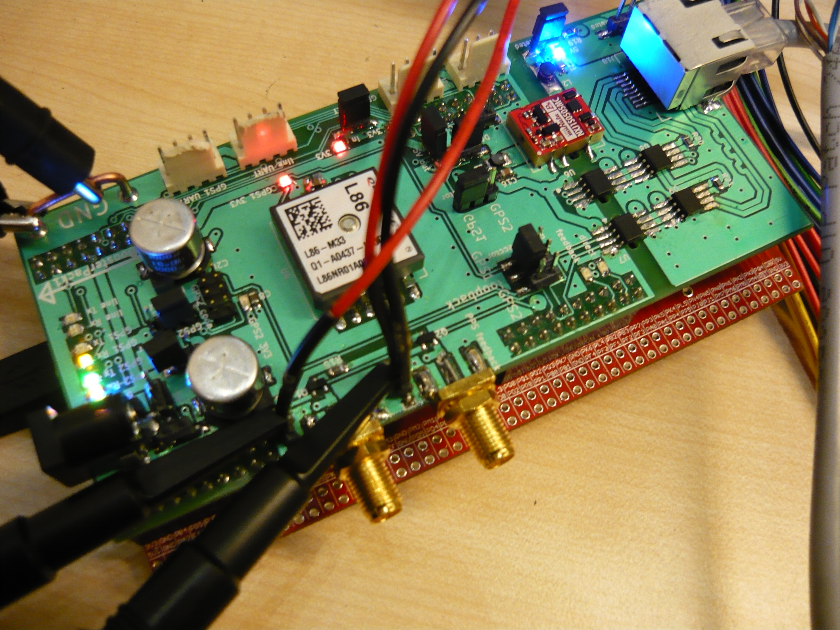
Interface/Hardware/measurements/PPS delay/cable loopback/pictures/P1130362.JPG
