aderhol/Clock_Synchronization/Interface/Hardware/measurements/PPS delay/cable loopback/pictures/P1130364.JPG

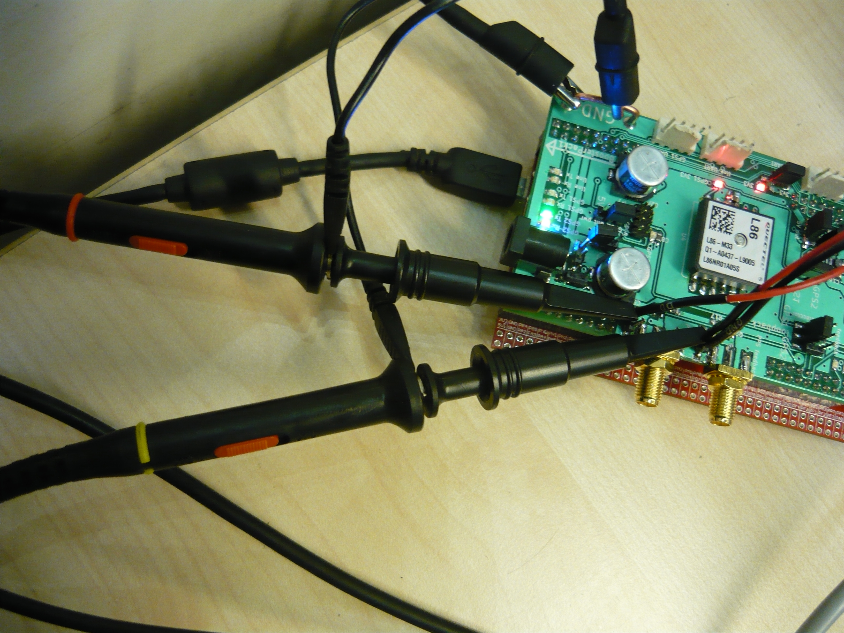
Interface/Hardware/measurements/PPS delay/cable loopback/pictures/P1130364.JPG
