aderhol/Clock_Synchronization/Interface/Hardware/measurements/PPS delay/cable loopback/pictures/P1130366.JPG

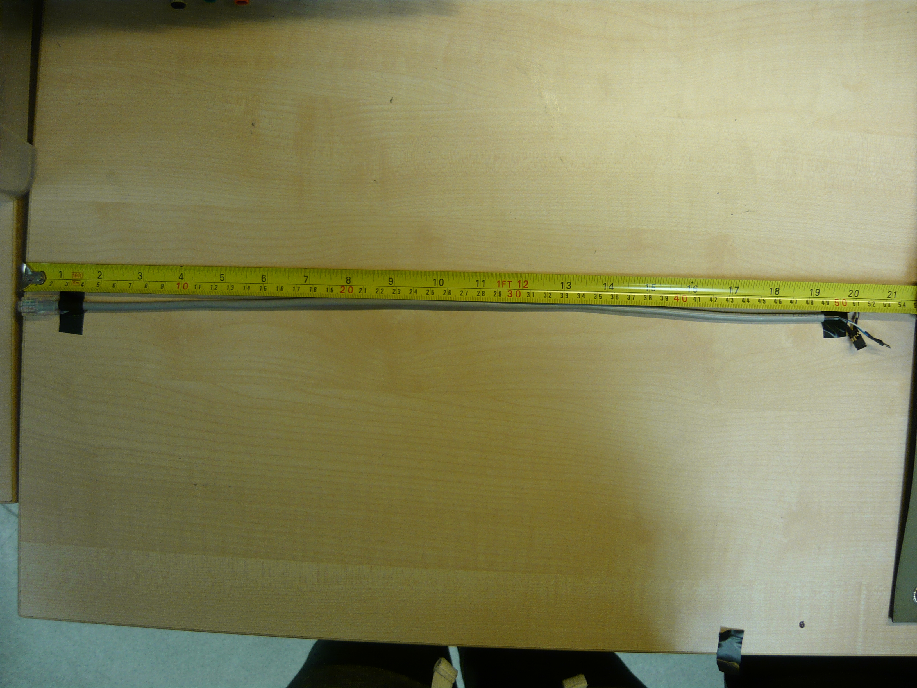
Interface/Hardware/measurements/PPS delay/cable loopback/pictures/P1130366.JPG
