aderhol/Clock_Synchronization/Interface/Hardware/measurements/PPS delay/direct loopback/Room Temperature/big.png

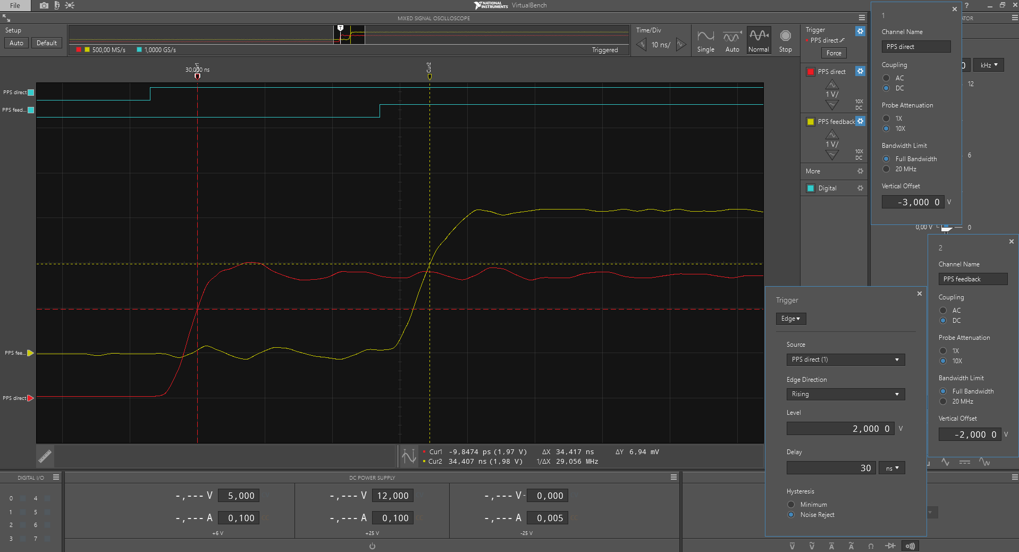
Interface/Hardware/measurements/PPS delay/direct loopback/Room Temperature/big.png
