aderhol/Clock_Synchronization/Interface/Hardware/measurements/PPS delay/direct loopback/Room Temperature/pictures/P1130358.JPG

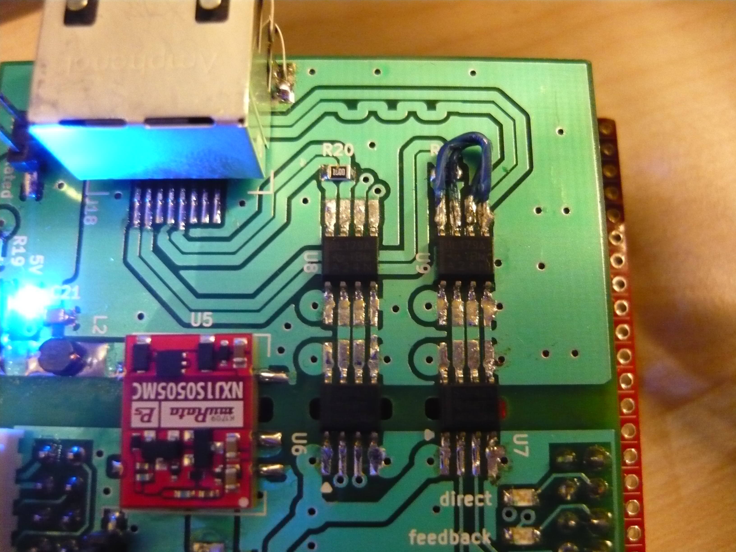
Interface/Hardware/measurements/PPS delay/direct loopback/Room Temperature/pictures/P1130358.JPG
