aderhol/Clock_Synchronization/Interface/Hardware/measurements/PPS delay/direct loopback/Room Temperature/scope.PNG

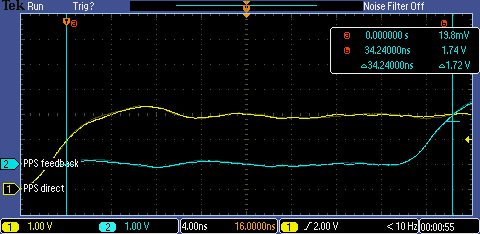
Interface/Hardware/measurements/PPS delay/direct loopback/Room Temperature/scope.PNG
