aderhol/Clock_Synchronization/Interface/Hardware/measurements/PPS delay/direct loopback/Room Temperature/small.png

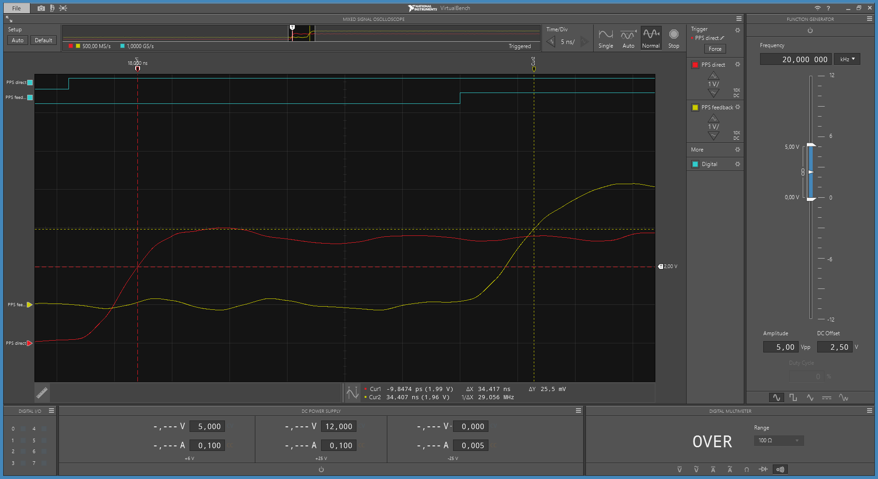
Interface/Hardware/measurements/PPS delay/direct loopback/Room Temperature/small.png
