aderhol/Clock_Synchronization/Interface/Hardware/measurements/PPS delay/direct loopback/Temperature Dependence/board#1/FLIR00084.bmp

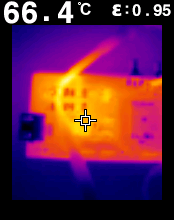
Interface/Hardware/measurements/PPS delay/direct loopback/Temperature Dependence/board#1/FLIR00084.bmp
