aderhol/Clock_Synchronization/Interface/Hardware/measurements/PPS delay/direct loopback/Temperature Dependence/board#1/P1140088.JPG

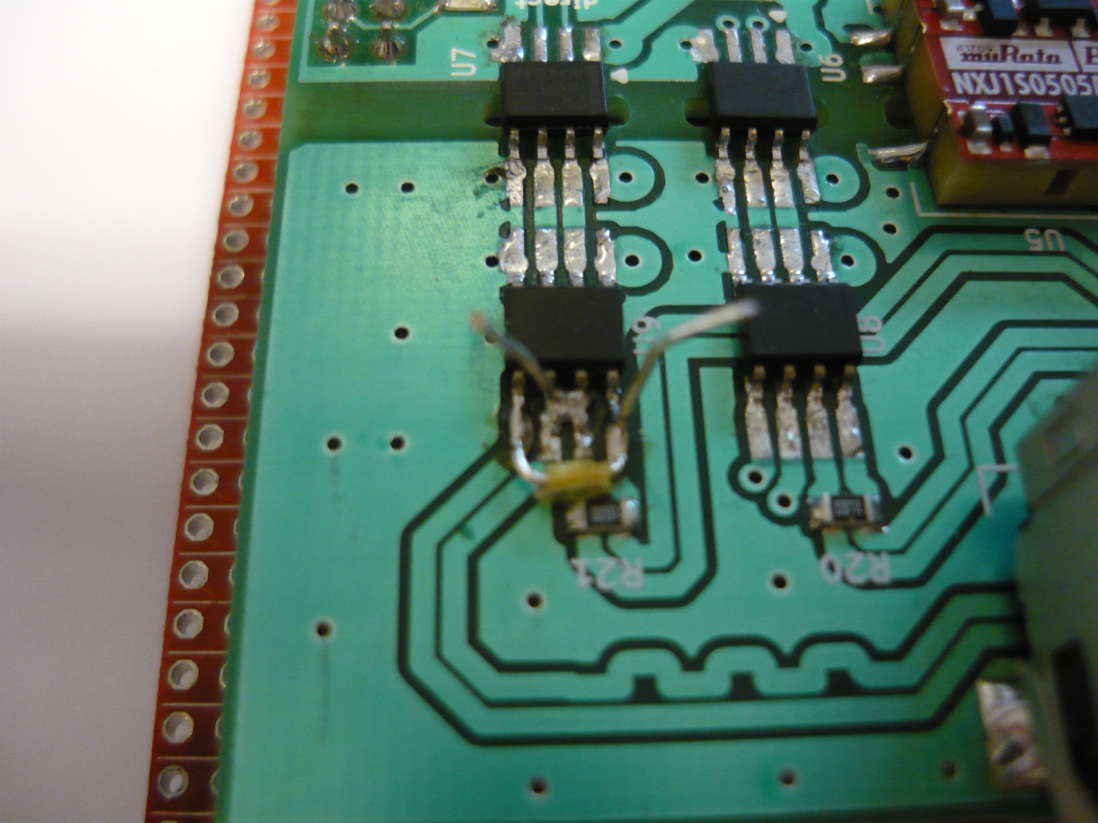
Interface/Hardware/measurements/PPS delay/direct loopback/Temperature Dependence/board#1/P1140088.JPG
