aderhol/Clock_Synchronization/Interface/Hardware/measurements/PPS delay/direct loopback/Temperature Dependence/board#2/33°C.png

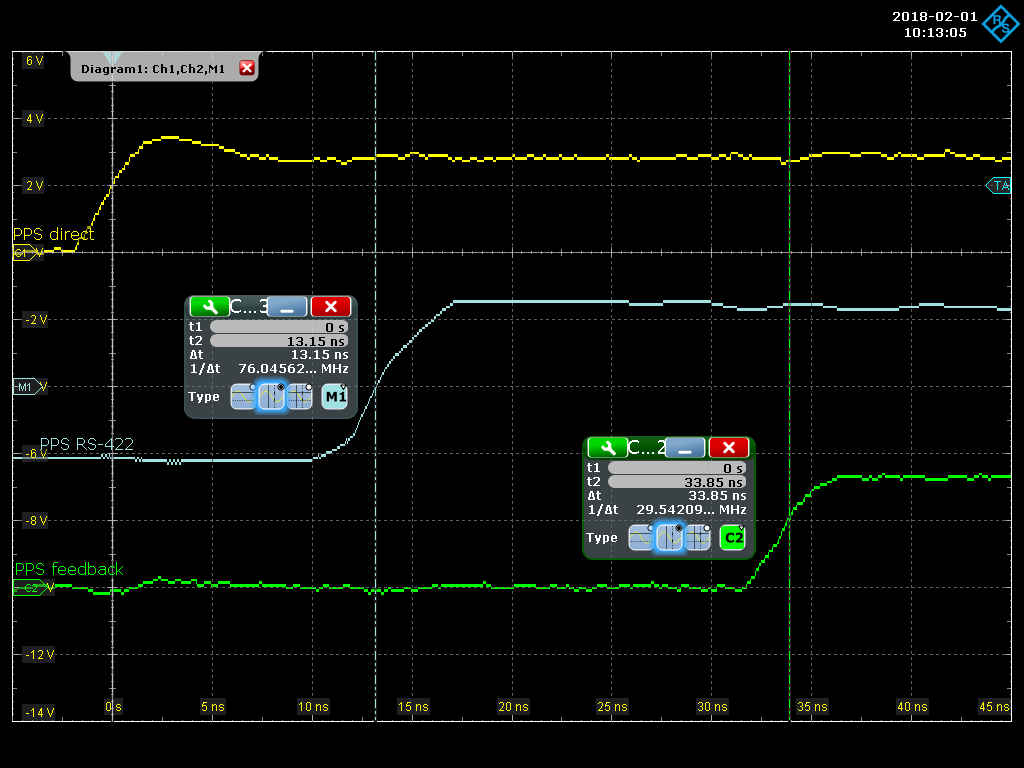
Interface/Hardware/measurements/PPS delay/direct loopback/Temperature Dependence/board#2/33°C.png
