aderhol/Clock_Synchronization/Interface/Hardware/measurements/PPS delay/direct loopback/Temperature Dependence/board#2/FLIR00076.bmp

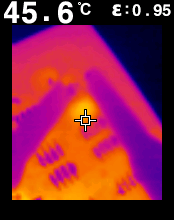
Interface/Hardware/measurements/PPS delay/direct loopback/Temperature Dependence/board#2/FLIR00076.bmp
