aderhol/Clock_Synchronization/Interface/Hardware/measurements/PPS delay/direct loopback/Temperature Dependence/board#2/FLIR00078.bmp

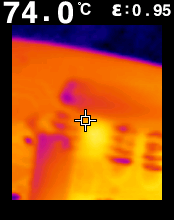
Interface/Hardware/measurements/PPS delay/direct loopback/Temperature Dependence/board#2/FLIR00078.bmp
