aderhol/Clock_Synchronization/Interface/Hardware/measurements/PPS delay/direct loopback/Temperature Dependence/board#2/jitter (10 minutes).png

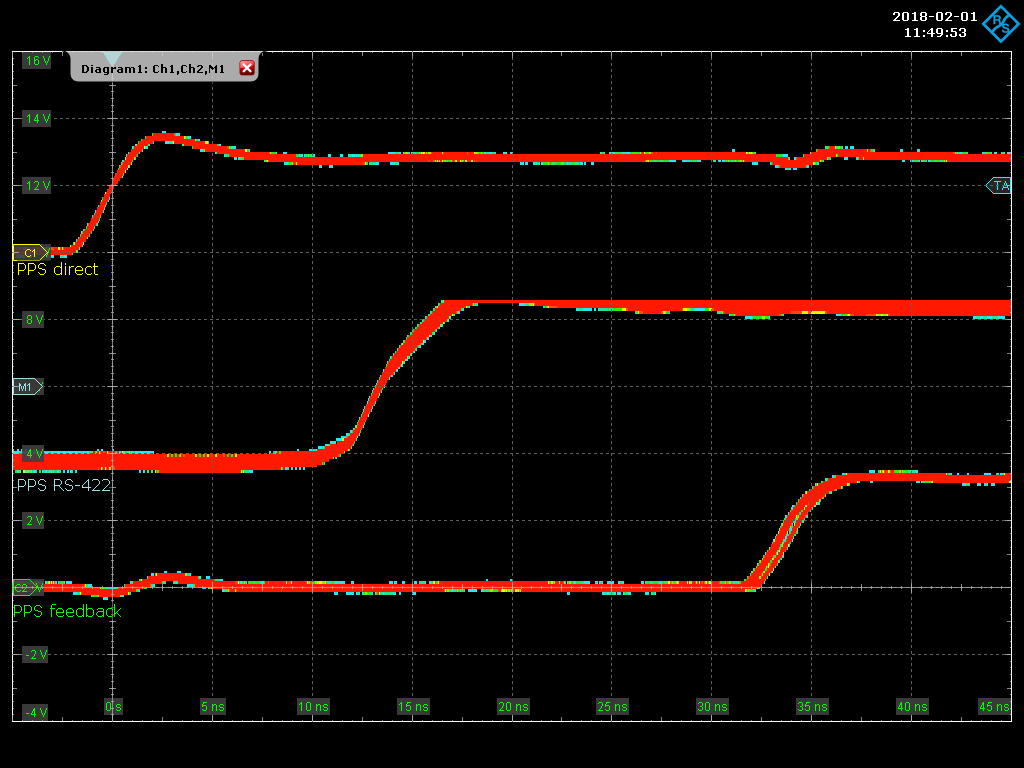
Interface/Hardware/measurements/PPS delay/direct loopback/Temperature Dependence/board#2/jitter (10 minutes).png
