aderhol/Clock_Synchronization/Interface/Hardware/measurements/PPS delay/direct loopback/Temperature Dependence/board#2/P1140081.JPG

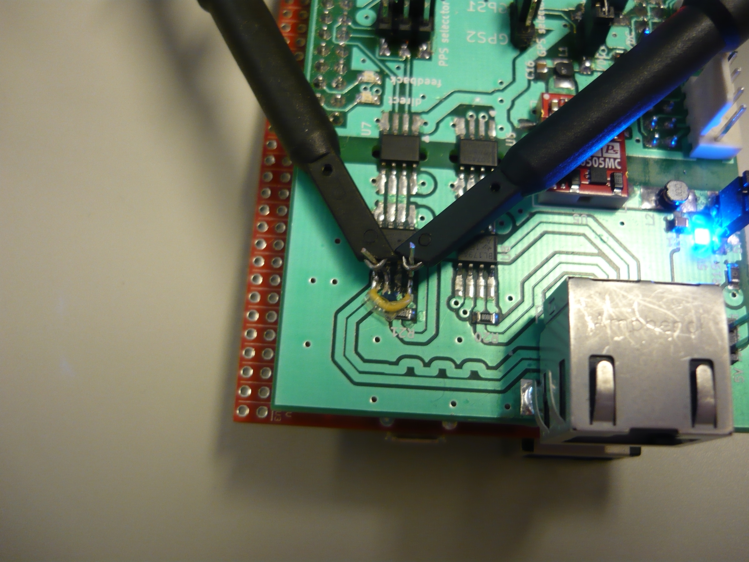
Interface/Hardware/measurements/PPS delay/direct loopback/Temperature Dependence/board#2/P1140081.JPG
