aderhol/Clock_Synchronization/Interface/Hardware/measurements/PPS delay/direct loopback/Temperature Dependence/board#2/P1140084.JPG

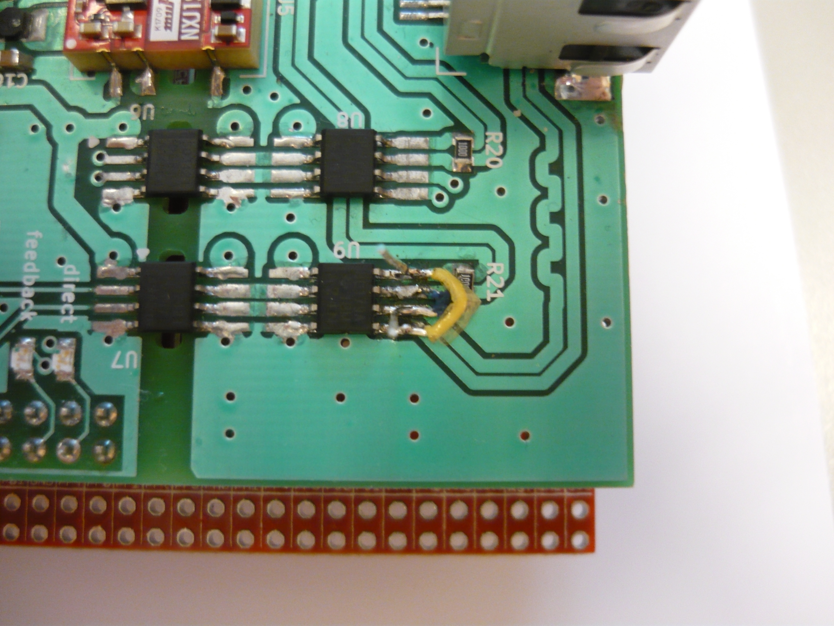
Interface/Hardware/measurements/PPS delay/direct loopback/Temperature Dependence/board#2/P1140084.JPG
