aderhol/Clock_Synchronization/(threads)

Thread 3 (2017-11-14):

touch up connection at (195, 98)

aderhol, 2017-11-14:
connect the via with the pin of the jumper correctly on the front copper

Closed 2017-11-15.

Thread 9 (2017-11-15):

fix pad positioning of L86's footprint

aderhol, 2017-11-15:

Thread 10 (2017-11-17):

fix misalignment with the processor board

aderhol, 2017-11-17:

Thread 16 (2017-11-19):

fix freeze-up upon connecting the RS-422 cable

aderhol, 2017-11-19:
