aderhol/Clock_Synchronization/Interface/Hardware/Interfacer Schematic Design.pdf

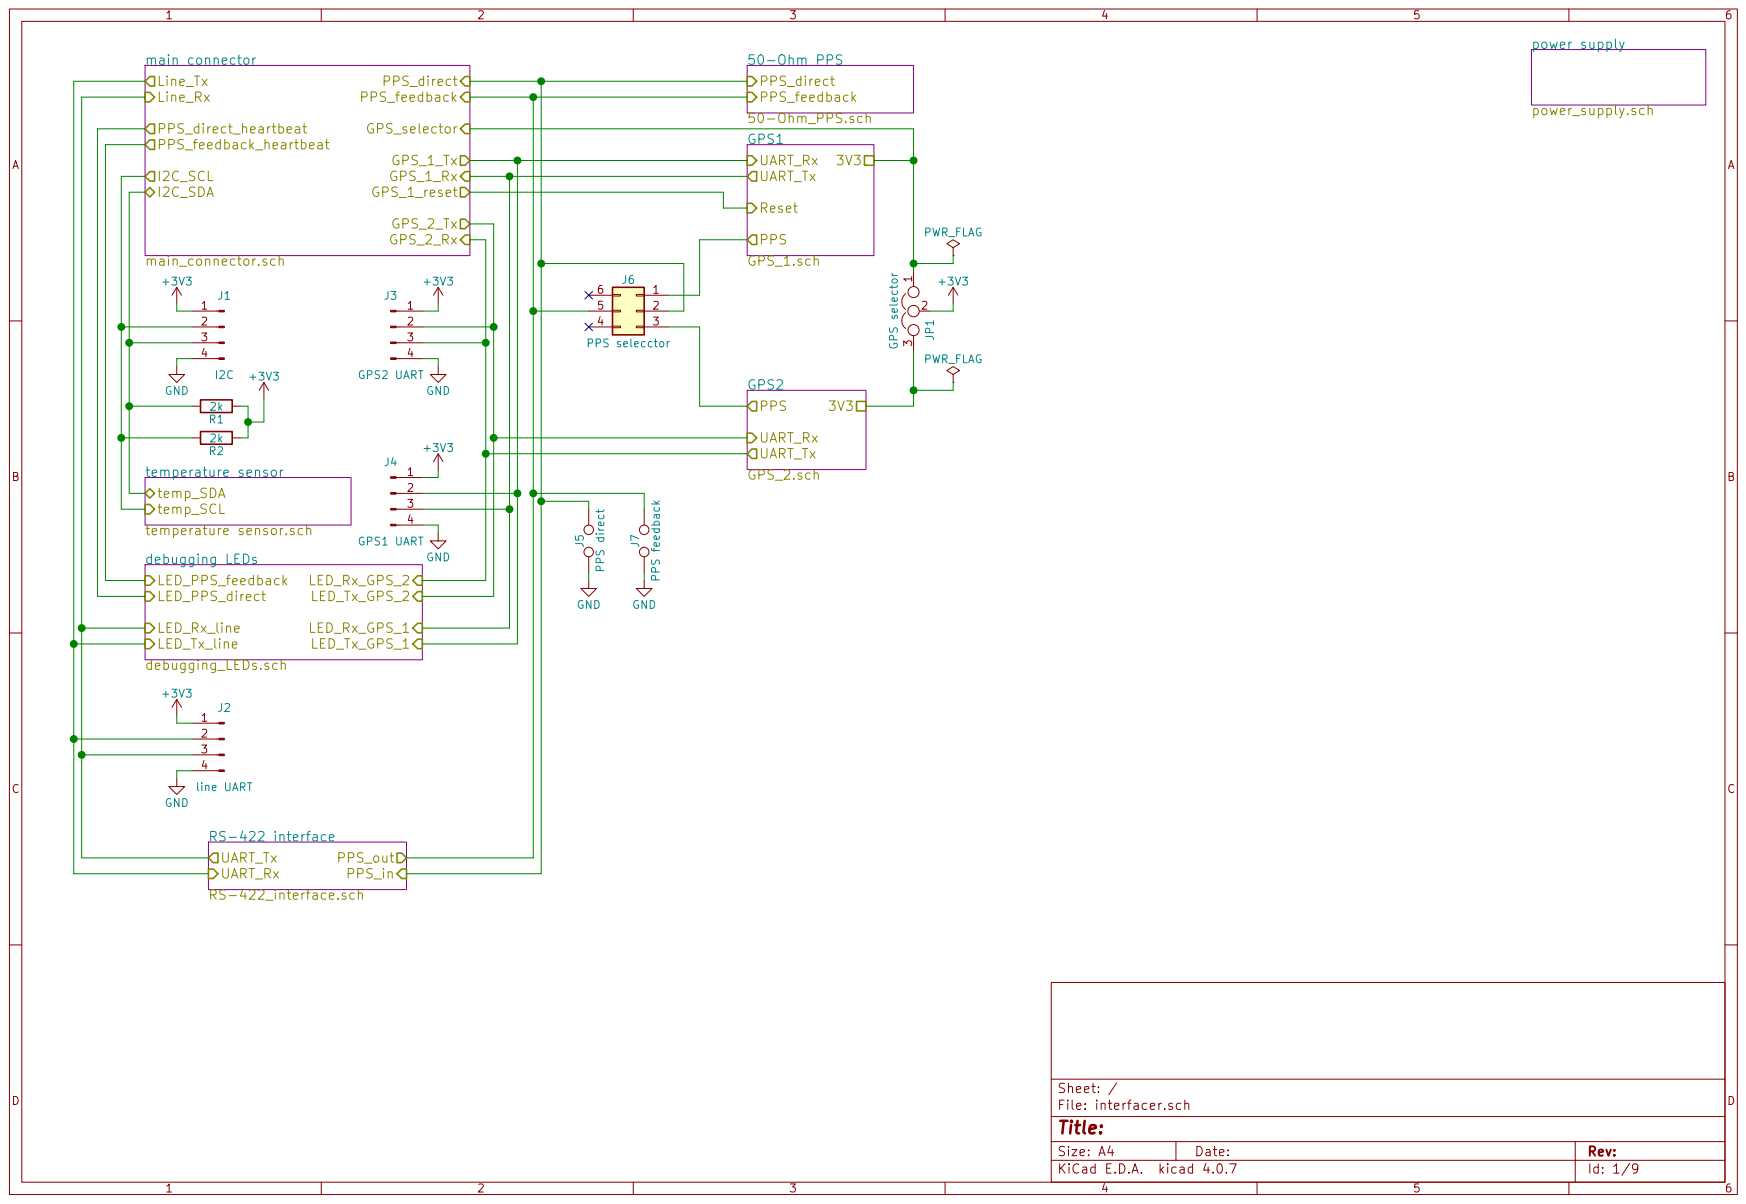
[picture p83: page 1]

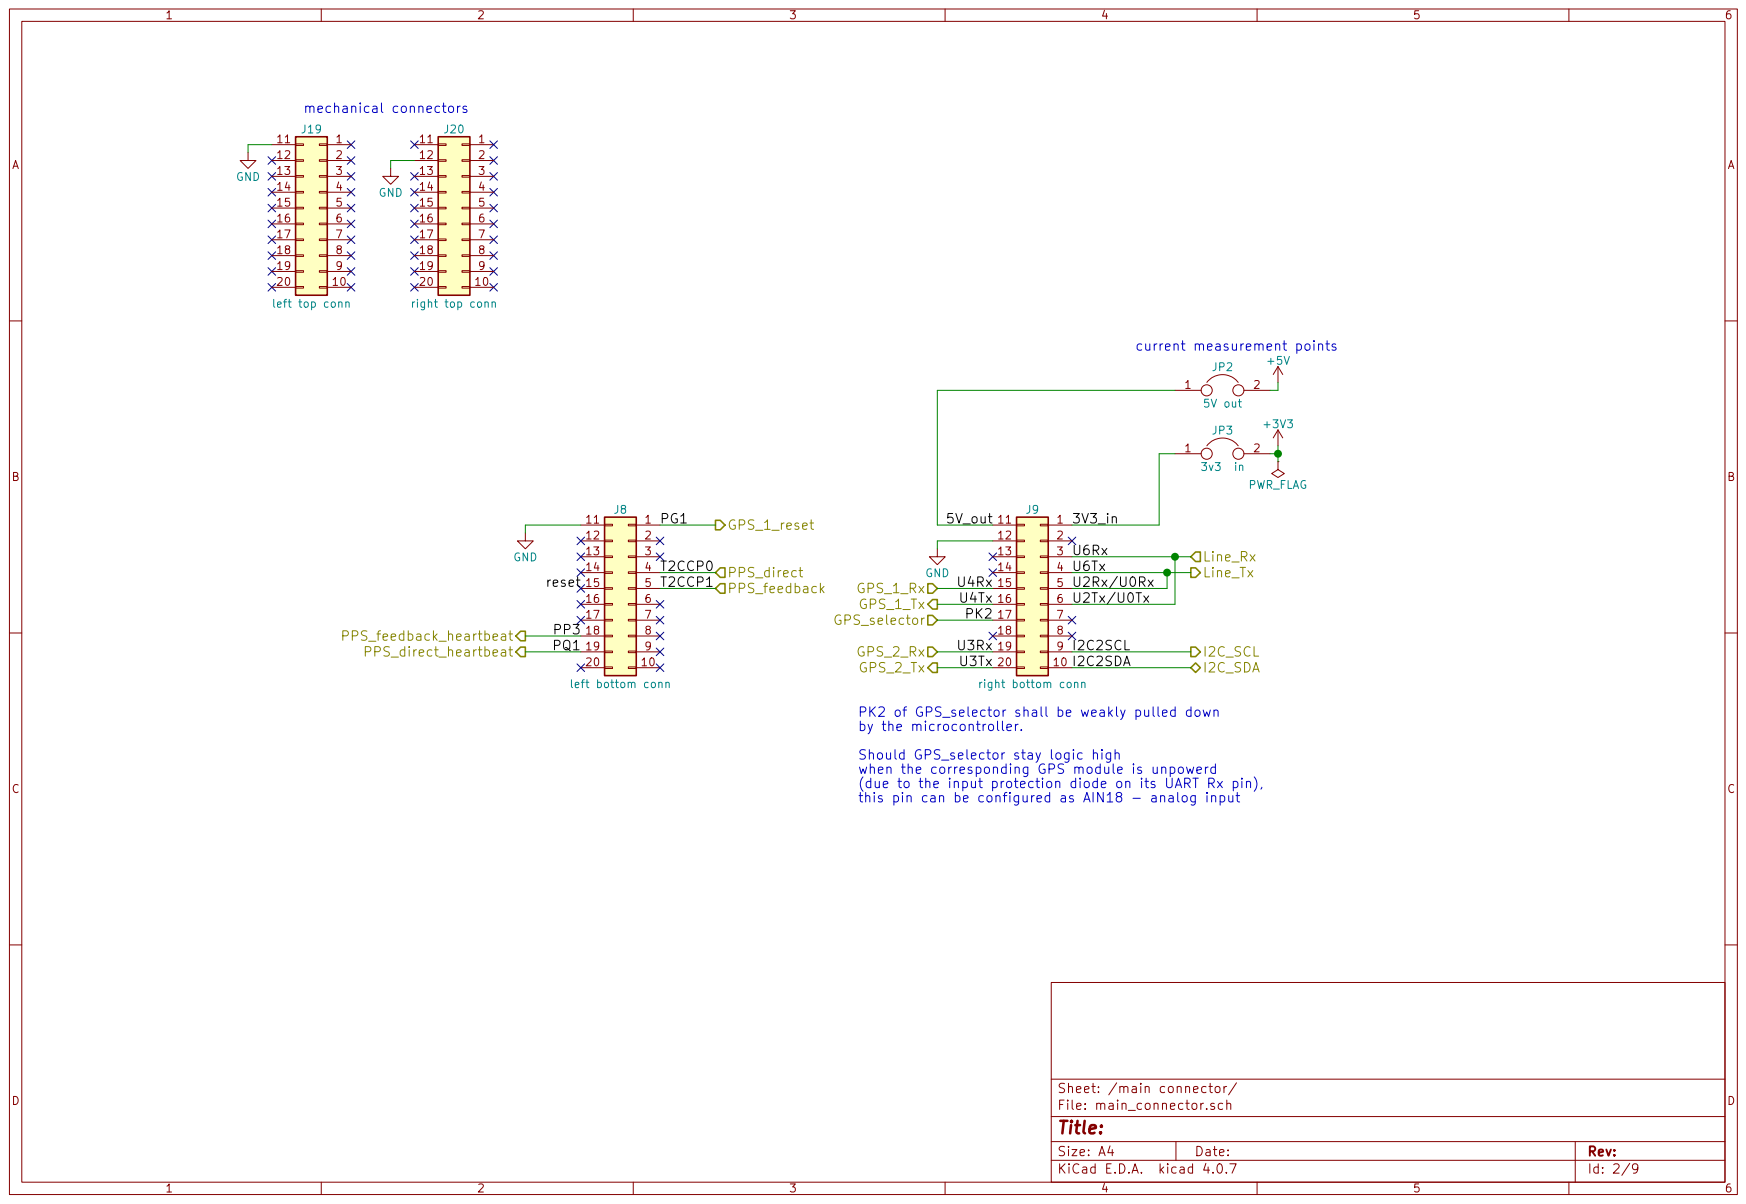
[picture p84: page 2]

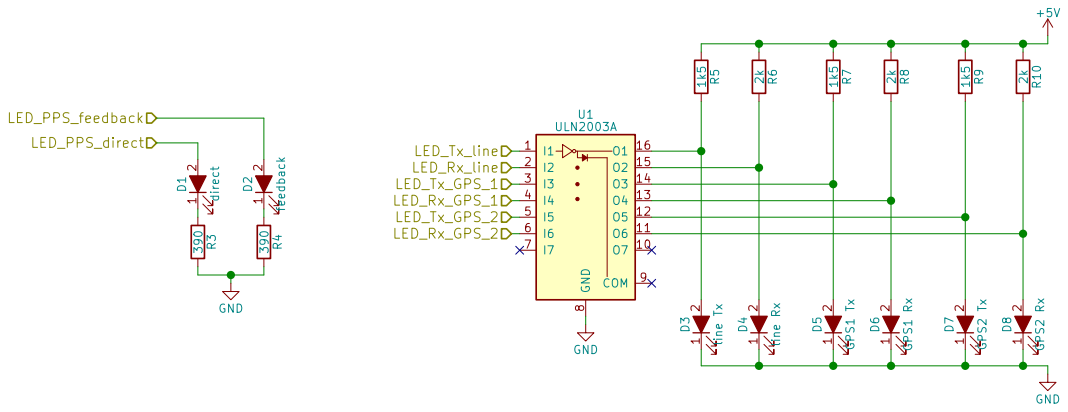
[picture p85: page 3]

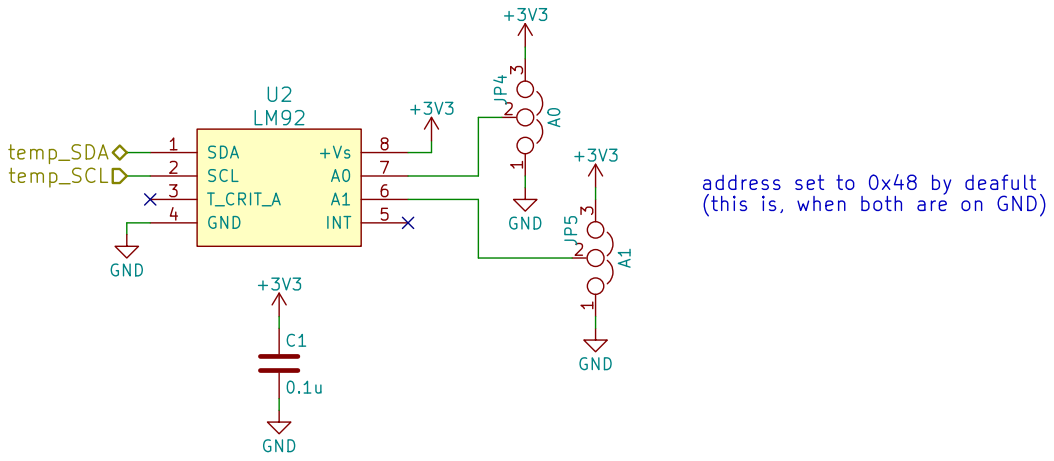
[picture p86: page 4]

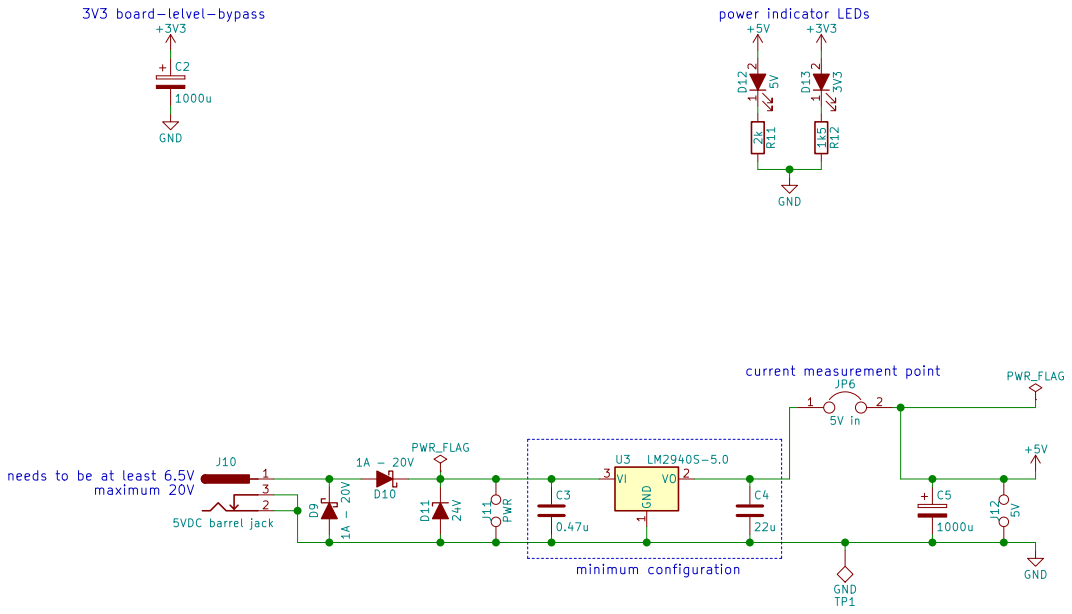
[picture p87: page 5]

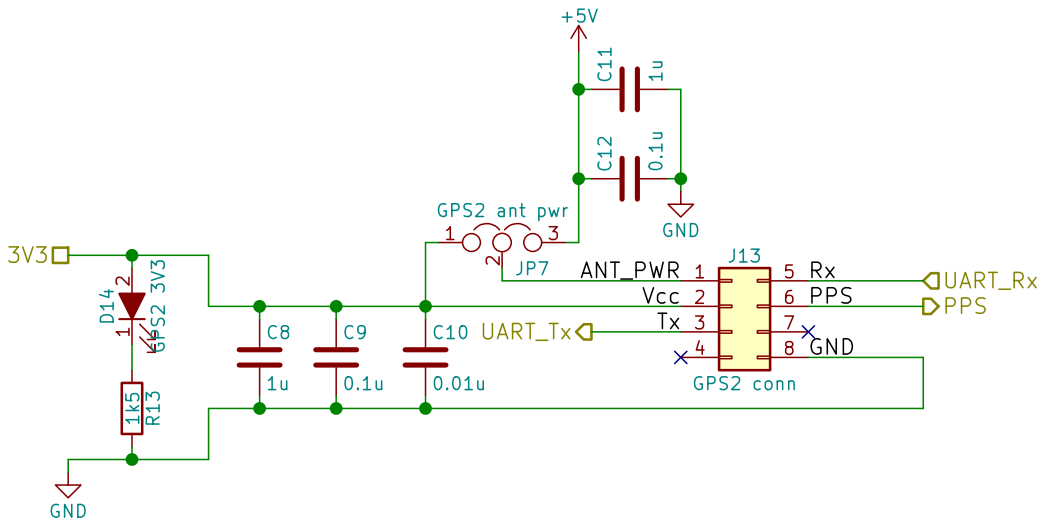
[picture p88: page 6]

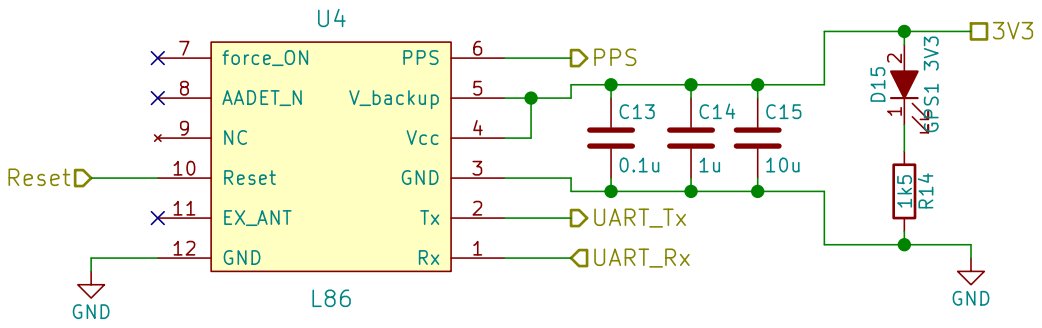
[picture p89: page 7]

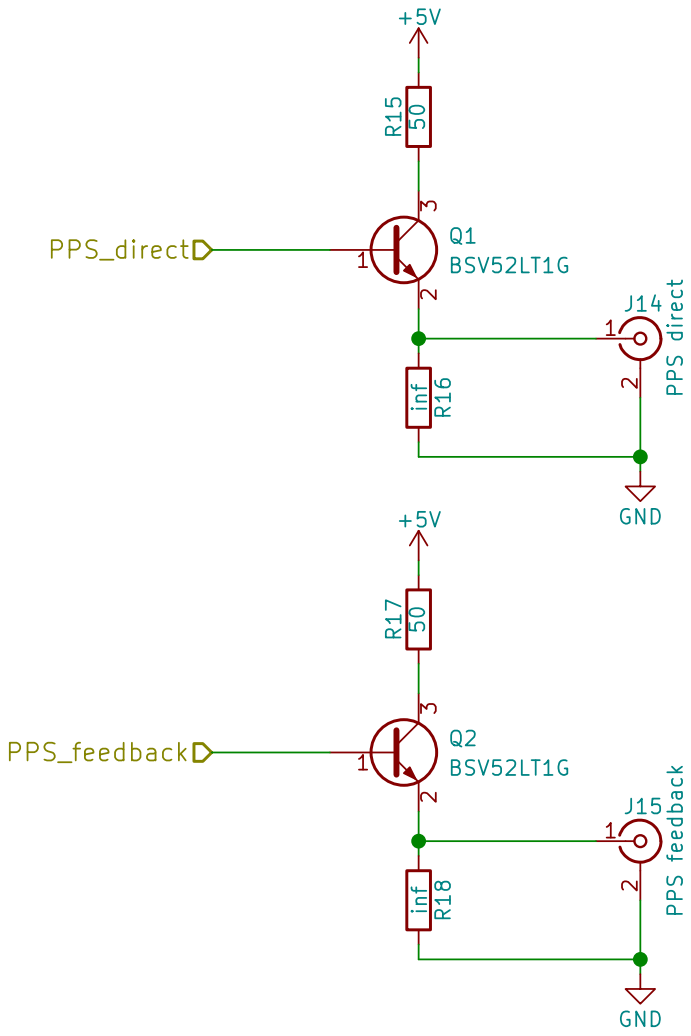
[picture p90: page 8]

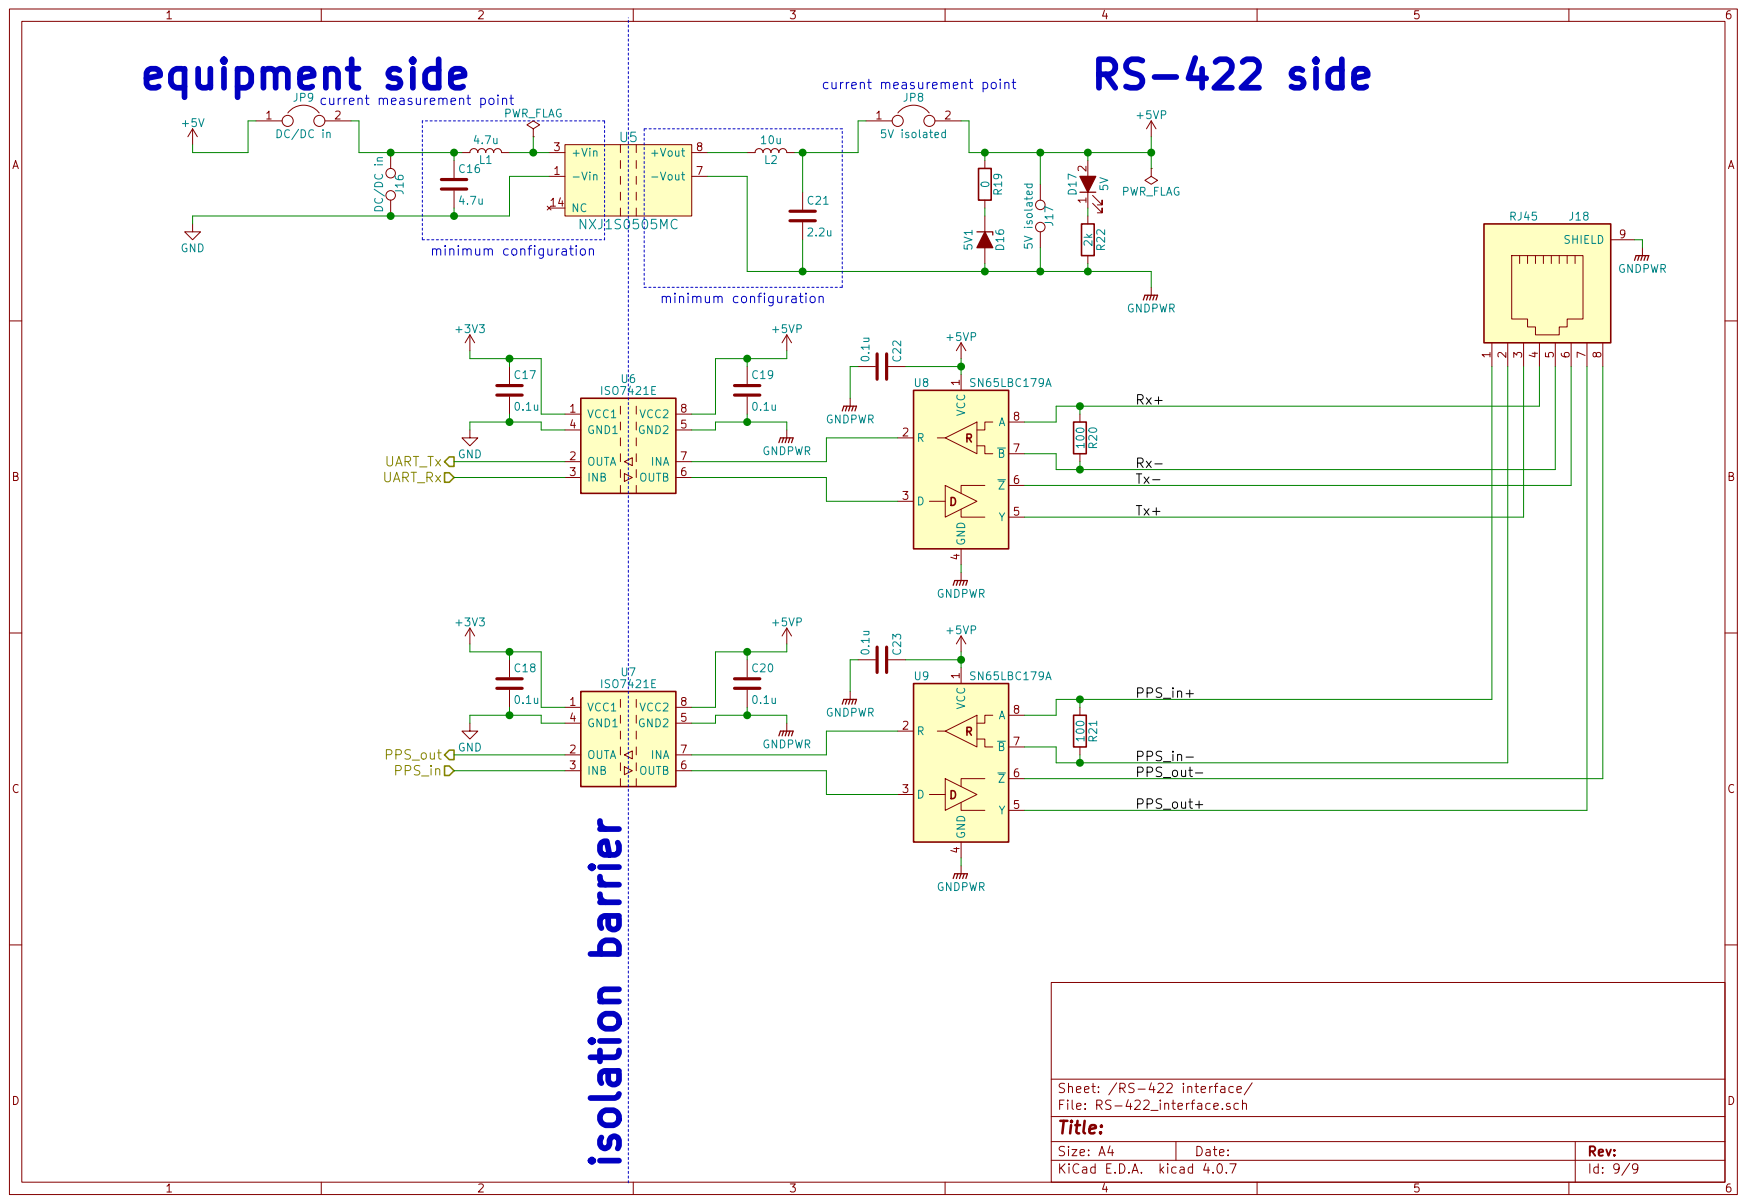
[picture p91: page 9]
