aderhol/Clock_Synchronization/Interface/Hardware/interfacer/interfacer.kicad_pcb

## KiCad design Interface/Hardware/interfacer/interfacer.kicad_pcb (2017-11-15)

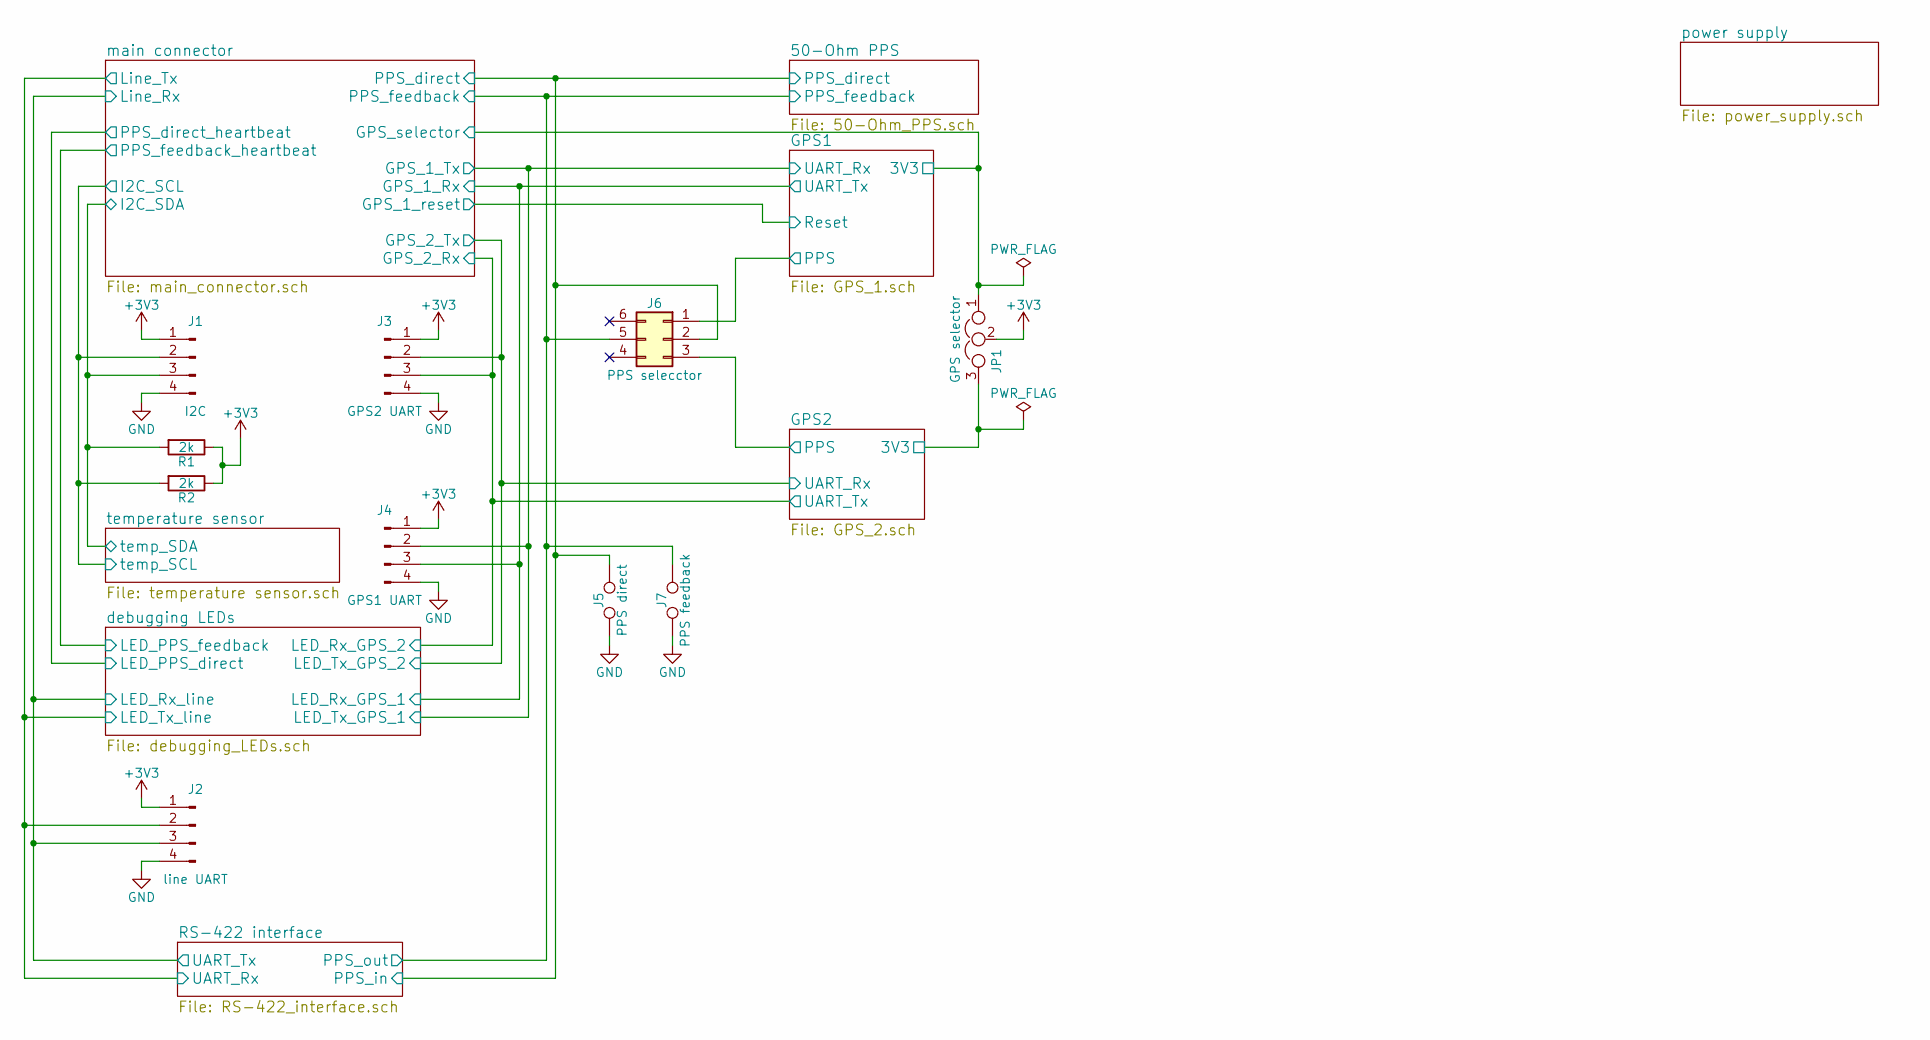
[picture p92: schematic interfacer.sch]

Parts:
J1: I2C; Molex_KK-6410-04_04x2.54mm_Straight; Part# NCW254-04S
J2: line UART; Molex_KK-6410-04_04x2.54mm_Straight; Part# NCW254-04S
J3: GPS2 UART; Molex_KK-6410-04_04x2.54mm_Straight; Part# NCW254-04S
J4: GPS1 UART; Molex_KK-6410-04_04x2.54mm_Straight; Part# NCW254-04S
J5: PPS direct; 2P_2.54_SMD
J6: PPS selecctor; Pin_Header_Straight_2x03_Pitch2.54mm_SMD_clockwise-numbering
J7: PPS feedback; 2P_2.54_SMD
JP1: GPS selector; 3P_2.54_jumper
R1, R2: 2k; 0805_2012

Connections:
+3V3: J1.1, J2.1, J3.1, J4.1, JP1.2, R1.1, R2.1; also elsewhere on the board
/50-Ohm PPS/PPS_direct: J5.2, J6.2; also elsewhere on the board
/50-Ohm PPS/PPS_feedback: J6.5, J7.2; also elsewhere on the board
/GPS1/3V3: JP1.1; also elsewhere on the board
/GPS1/PPS: J6.1; also elsewhere on the board
/GPS2/3V3: JP1.3; also elsewhere on the board
/GPS2/PPS: J6.3; also elsewhere on the board
/debugging LEDs/LED_Rx_line: J2.3; also elsewhere on the board
/debugging LEDs/LED_Tx_line: J2.2; also elsewhere on the board
/main connector/GPS_1_Rx: J4.3; also elsewhere on the board
/main connector/GPS_1_Tx: J4.2; also elsewhere on the board
/main connector/GPS_2_Rx: J3.3; also elsewhere on the board
/main connector/GPS_2_Tx: J3.2; also elsewhere on the board
/main connector/I2C_SCL: J1.2, R2.2; also elsewhere on the board
/main connector/I2C_SDA: J1.3, R1.2; also elsewhere on the board
GND: J1.4, J2.4, J3.4, J4.4, J5.1, J7.1; also elsewhere on the board

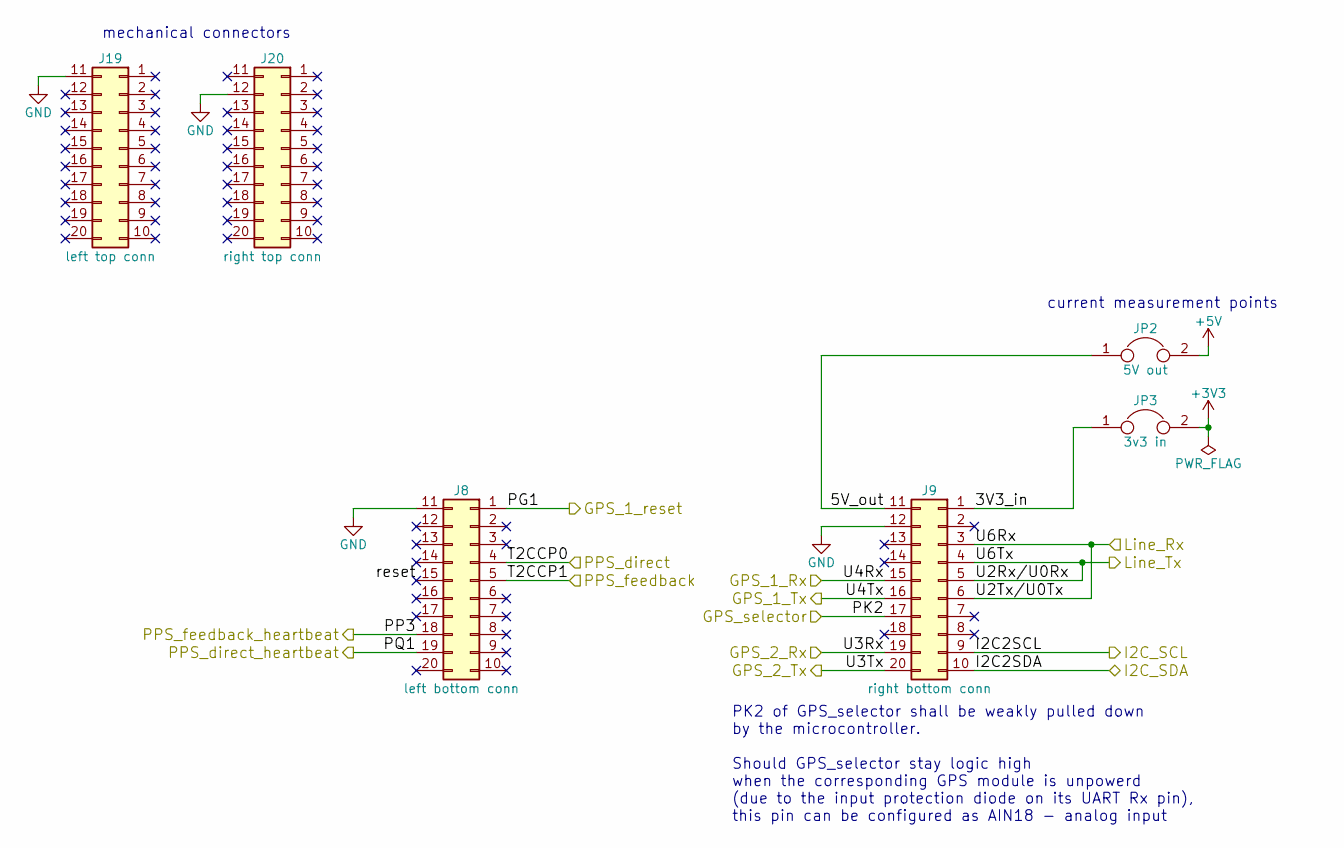
[picture p93: schematic main_connector.sch]

Parts:
J8: left bottom conn; Pin_Header_Straight_2x10_Pitch2.54mm_column-numbering
J9: right bottom conn; Pin_Header_Straight_2x10_Pitch2.54mm_column-numbering
J19: left top conn; Pin_Header_Straight_2x10_Pitch2.54mm_column-numbering
J20: right top conn; Pin_Header_Straight_2x10_Pitch2.54mm_column-numbering
JP2: 5V out; 2P_2.54_SMD
JP3: 3v3 in; 2P_2.54_SMD

Connections:
+3V3: JP3.2; also elsewhere on the board
+5V: JP2.2; also elsewhere on the board
/50-Ohm PPS/PPS_direct: J8.4; also elsewhere on the board
/50-Ohm PPS/PPS_feedback: J8.5; also elsewhere on the board
/GPS1/3V3: J9.17; also elsewhere on the board
/debugging LEDs/LED_PPS_direct: J8.19; also elsewhere on the board
/debugging LEDs/LED_PPS_feedback: J8.18; also elsewhere on the board
/debugging LEDs/LED_Rx_line: J9.3, J9.6; also elsewhere on the board
/debugging LEDs/LED_Tx_line: J9.4, J9.5; also elsewhere on the board
/main connector/3V3_in: J9.1, JP3.1
/main connector/5V_out: J9.11, JP2.1
/main connector/GPS_1_Rx: J9.15; also elsewhere on the board
/main connector/GPS_1_Tx: J9.16; also elsewhere on the board
/main connector/GPS_1_reset: J8.1; also elsewhere on the board
/main connector/GPS_2_Rx: J9.19; also elsewhere on the board
/main connector/GPS_2_Tx: J9.20; also elsewhere on the board
/main connector/I2C_SCL: J9.9; also elsewhere on the board
/main connector/I2C_SDA: J9.10; also elsewhere on the board
/main connector/reset: J8.15
GND: J8.11, J9.12, J19.11, J20.12; also elsewhere on the board

Notes on the sheet:
current measurement points
PK2 of GPS_selector shall be weakly pulled down by the microcontroller. Should GPS_selector stay logic high when the corresponding GPS module is unpowerd (due to the input protection diode on its UART Rx pin), this pin can be configured as AIN18 - analog input
mechanical connectors

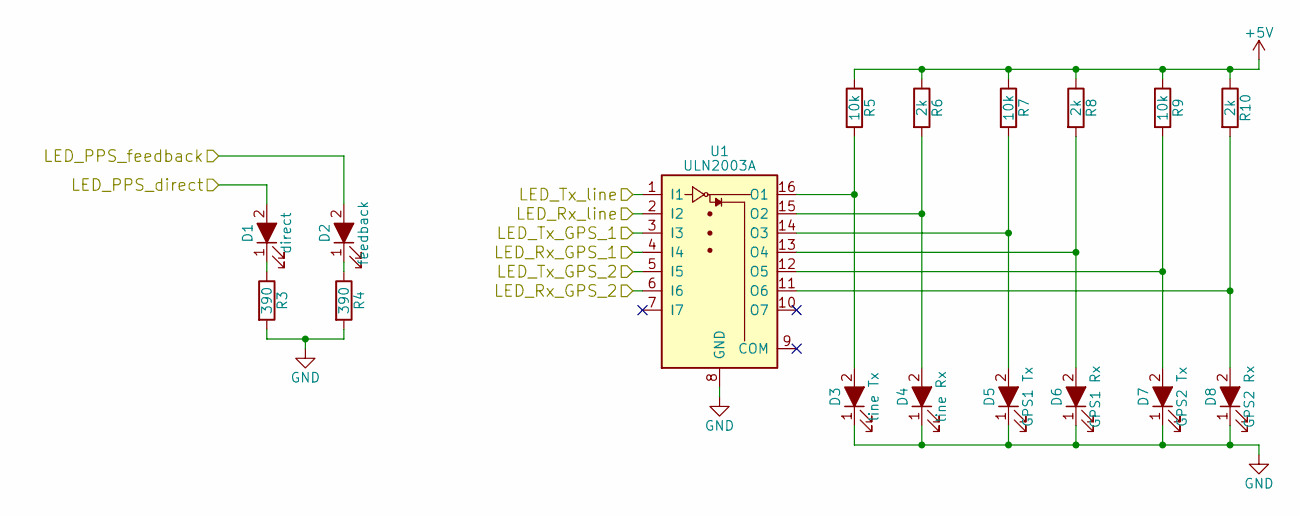
[picture p94: schematic debugging_LEDs.sch]

Parts:
D1: direct; 0805_2012; Part# FYLS-0805UBC
D2: feedback; 0805_2012; Part# FYLS-0805UBC
D3: line Tx; 0805_2012; Part# FYLS-0805PGC
D4: line Rx; 0805_2012; Part# KP-2012SYC
D5: GPS1 Tx; 0805_2012; Part# FYLS-0805PGC
D6: GPS1 Rx; 0805_2012; Part# KP-2012SYC
D7: GPS2 Tx; 0805_2012; Part# FYLS-0805PGC
D8: GPS2 Rx; 0805_2012; Part# KP-2012SYC
R3, R4: 390; 0805_2012
R5, R7, R9: 10k; 0805_2012
R6, R8, R10: 2k; 0805_2012
U1: ULN2003A; SOIC-16

Connections:
+5V: R5.1, R6.1, R7.1, R8.1, R9.1, R10.1; also elsewhere on the board
/debugging LEDs/LED_PPS_direct: D1.2 (A); also elsewhere on the board
/debugging LEDs/LED_PPS_feedback: D2.2 (A); also elsewhere on the board
/debugging LEDs/LED_Rx_line: U1.2 (I2); also elsewhere on the board
/debugging LEDs/LED_Tx_line: U1.1 (I1); also elsewhere on the board
/main connector/GPS_1_Rx: U1.4 (I4); also elsewhere on the board
/main connector/GPS_1_Tx: U1.3 (I3); also elsewhere on the board
/main connector/GPS_2_Rx: U1.6 (I6); also elsewhere on the board
/main connector/GPS_2_Tx: U1.5 (I5); also elsewhere on the board
GND: D3.1 (K), D4.1 (K), D5.1 (K), D6.1 (K), D7.1 (K), D8.1 (K), R3.2, R4.2, U1.8 (GND); also elsewhere on the board
unnamed: D1.1 (K), R3.1
unnamed: D2.1 (K), R4.1
unnamed: D3.2 (A), R5.2, U1.16 (O1)
unnamed: D4.2 (A), R6.2, U1.15 (O2)
unnamed: D5.2 (A), R7.2, U1.14 (O3)
unnamed: D6.2 (A), R8.2, U1.13 (O4)
unnamed: D7.2 (A), R9.2, U1.12 (O5)
unnamed: D8.2 (A), R10.2, U1.11 (O6)

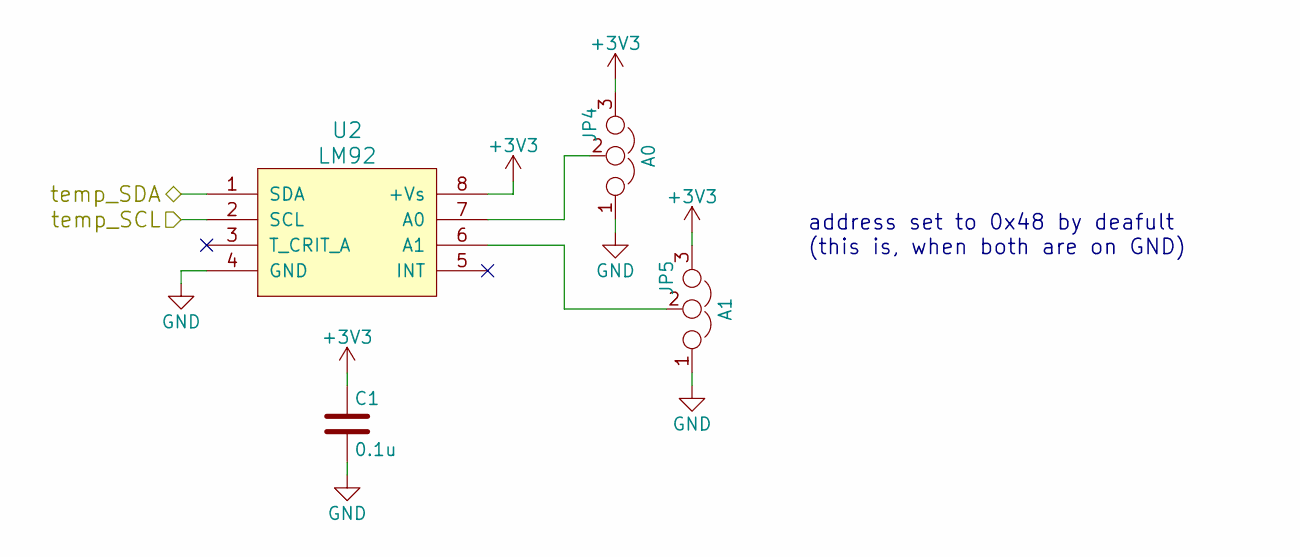
[picture p95: schematic temperature sensor.sch]

Parts:
C1: 0.1u; 0805_2012
JP4: A0; 0_Ohm_jumper
JP5: A1; 0_Ohm_jumper
U2: LM92; SOIC-8

Connections:
+3V3: C1.1, JP4.3, JP5.3, U2.8 (+Vs); also elsewhere on the board
/main connector/I2C_SCL: U2.2 (SCL); also elsewhere on the board
/main connector/I2C_SDA: U2.1 (SDA); also elsewhere on the board
GND: C1.2, JP4.1, JP5.1, U2.4 (GND); also elsewhere on the board
unnamed: JP4.2, U2.7 (A0)
unnamed: JP5.2, U2.6 (A1)

Notes on the sheet:
address set to 0x48 by deafult (this is, when both are on GND)

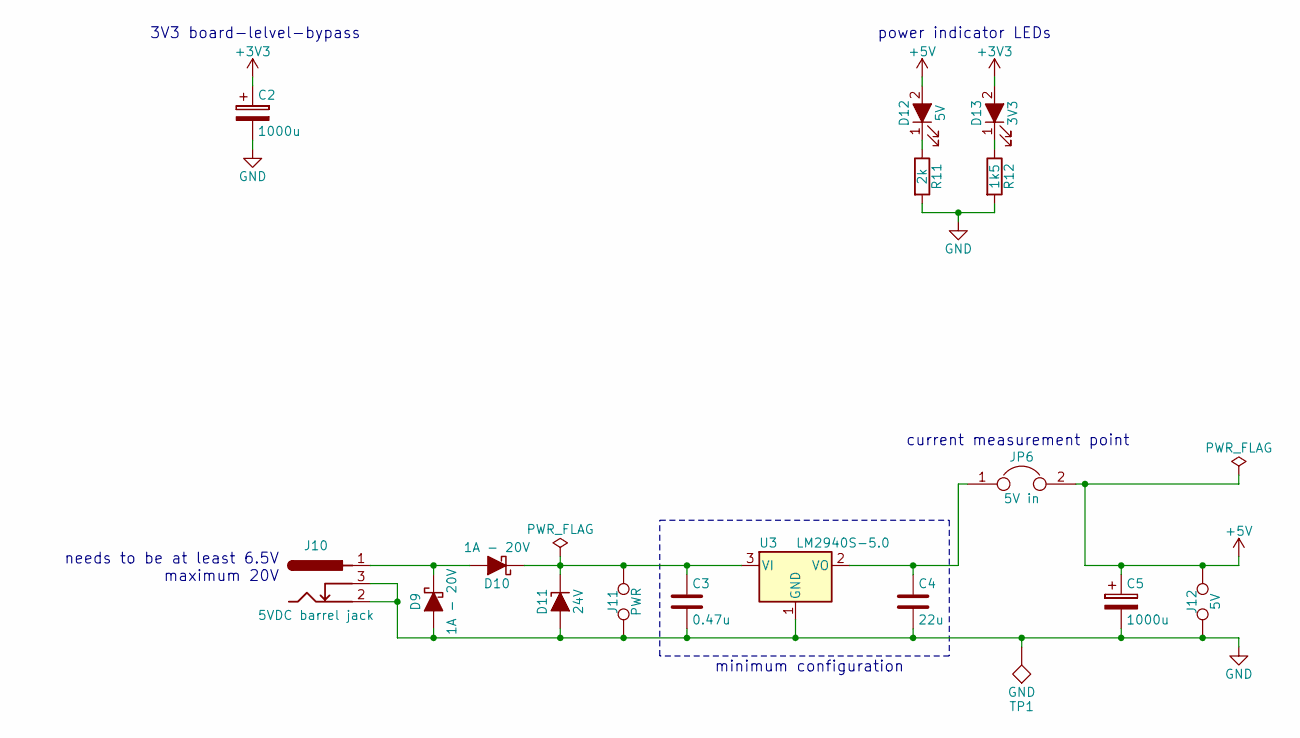
[picture p96: schematic power_supply.sch]

Parts:
C2, C5: 1000u; CP_Elec_10x10; Part# RVJ-10V102MH10U-R2
C3: 0.47u; 0805_2012
C4: 22u; 0805_2012
D9, D10: 1A - 20V; D_SMA; Part# SSL12L
D11: 24V; D_MiniMELF; Part# TZMC24-GS08
D12: 5V; 0805_2012; Part# FYLS-0805UBC
D13: 3V3; 0805_2012; part# KP-2012SURC
J10: 5VDC barrel jack; BARREL_JACK; Part# DCS-5521-5
J11: PWR; 2P_2.54_SMD
J12: 5V; 2P_2.54_SMD
JP6: 5V in; 2P_2.54_SMD
R11: 2k; 0805_2012
R12: 1k5; 0805_2012
TP1: GND; GND_probe
U3: LM2940S-5.0; TO-263-3_TabPinMiddle

Connections:
+3V3: C2.1, D13.2 (A); also elsewhere on the board
+5V: C5.1, D12.2 (A), J12.2, JP6.2; also elsewhere on the board
GND: C2.2, C3.2, C4.2, C5.2, D9.2 (A), D11.2 (A), J10.2, J10.3, J11.1, J12.1, R11.2, R12.2, TP1.1, U3.1 (GND); also elsewhere on the board
unnamed: C3.1, D10.1 (K), D11.1 (K), J11.2, U3.3 (VI)
unnamed: C4.1, JP6.1, U3.2 (VO)
unnamed: D9.1 (K), D10.2 (A), J10.1
unnamed: D12.1 (K), R11.1
unnamed: D13.1 (K), R12.1

Notes on the sheet:
power indicator LEDs
3V3 board-lelvel-bypass
current measurement point
needs to be at least 6.5V maximum 20V
minimum configuration

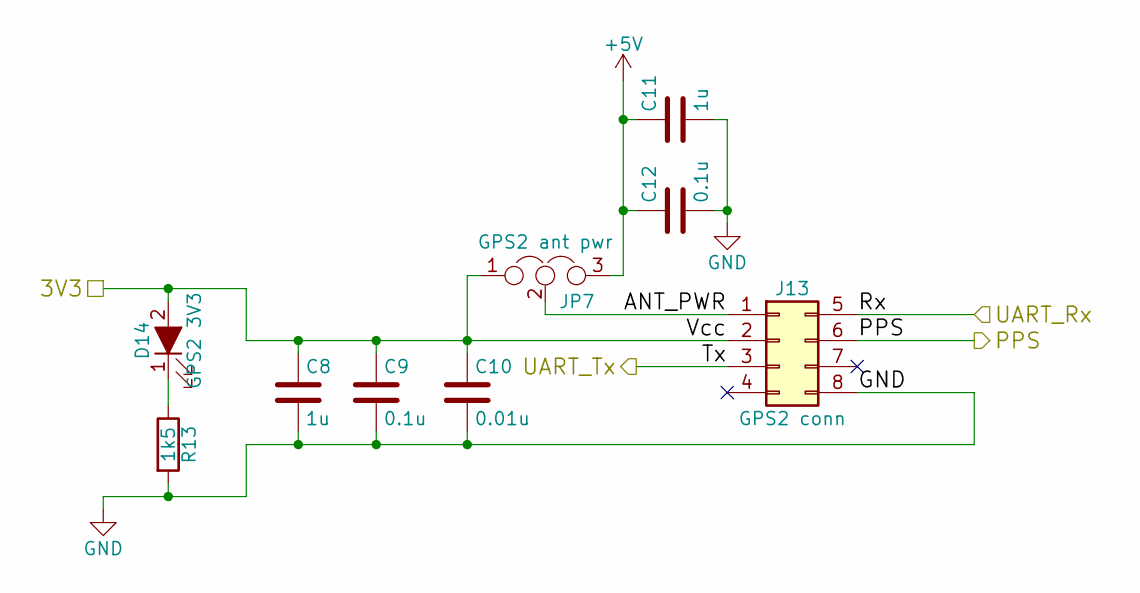
[picture p97: schematic GPS_2.sch]

Parts:
C8, C11: 1u; 0805_2012
C9, C12: 0.1u; 0805_2012
C10: 0.01u; 0805_2012
D14: GPS2 3V3; 0805_2012; part# KP-2012SURC
J13: GPS2 conn; Pin_Header_Straight_2x04_Pitch2.00mm_column-numbering
JP7: GPS2 ant pwr; 3P_2.54_jumper
R13: 1k5; 0805_2012

Connections:
+5V: C11.1, C12.1, JP7.3; also elsewhere on the board
/GPS2/3V3: C8.1, C9.1, C10.1, D14.2 (A), J13.2, JP7.1; also elsewhere on the board
/GPS2/ANT_PWR: J13.1, JP7.2
/GPS2/PPS: J13.6; also elsewhere on the board
/main connector/GPS_2_Rx: J13.3; also elsewhere on the board
/main connector/GPS_2_Tx: J13.5; also elsewhere on the board
GND: C8.2, C9.2, C10.2, C11.2, C12.2, J13.8, R13.2; also elsewhere on the board
unnamed: D14.1 (K), R13.1

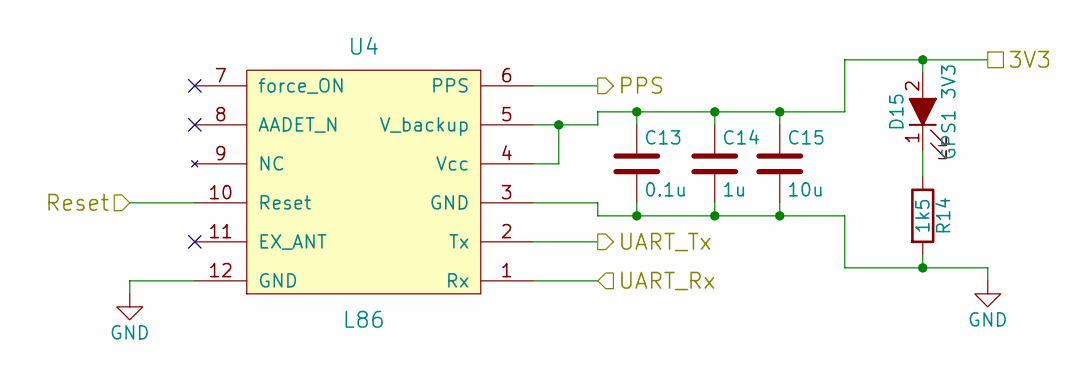
[picture p98: schematic GPS_1.sch]

Parts:
C13: 0.1u; 0805_2012
C14: 1u; 0805_2012
C15: 10u; 0805_2012
D15: GPS1 3V3; 0805_2012; part# KP-2012SURC
R14: 1k5; 0805_2012
U4: L86

Connections:
/GPS1/3V3: C13.1, C14.1, C15.1, D15.2 (A), U4.4 (Vcc), U4.5 (V_backup); also elsewhere on the board
/GPS1/PPS: U4.6 (PPS); also elsewhere on the board
/main connector/GPS_1_Rx: U4.2 (Tx); also elsewhere on the board
/main connector/GPS_1_Tx: U4.1 (Rx); also elsewhere on the board
/main connector/GPS_1_reset: U4.10 (Reset); also elsewhere on the board
GND: C13.2, C14.2, C15.2, R14.2, U4.3 (GND), U4.12 (GND); also elsewhere on the board
unnamed: D15.1 (K), R14.1

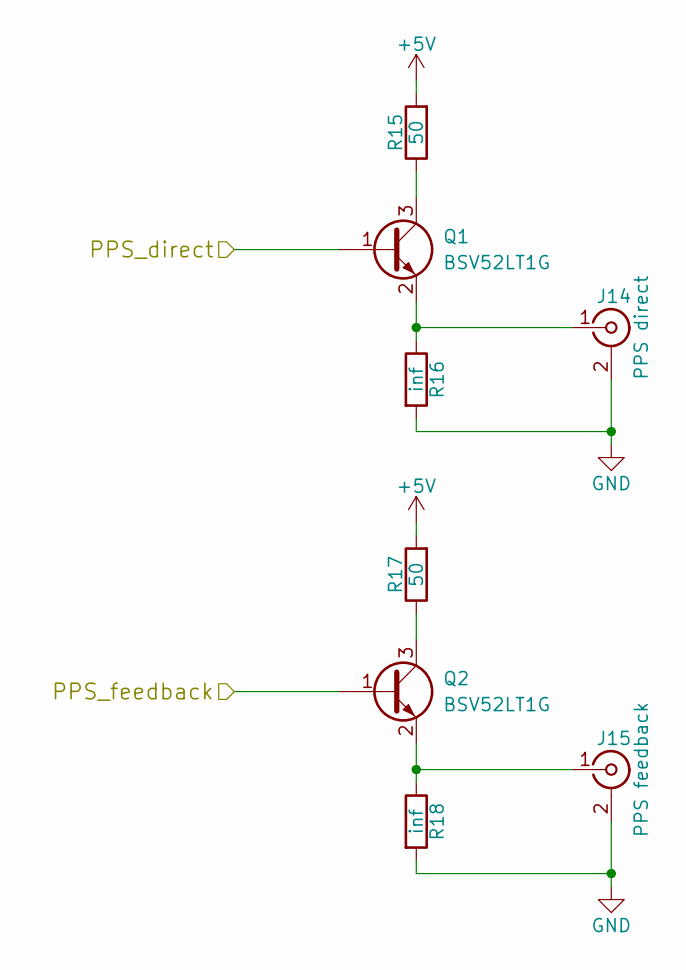
[picture p99: schematic 50-Ohm_PPS.sch]

Parts:
J14: PPS direct; Molex_SMA_Jack_Edge_Mount
J15: PPS feedback; Molex_SMA_Jack_Edge_Mount
Q1, Q2: BSV52LT1G; SOT-23
R15, R17: 50; 0805_2012
R16, R18: inf; 0805_2012

Connections:
+5V: R15.2, R17.2; also elsewhere on the board
/50-Ohm PPS/PPS_direct: Q1.1 (B); also elsewhere on the board
/50-Ohm PPS/PPS_feedback: Q2.1 (B); also elsewhere on the board
GND: J14.2 (Ext), J15.2 (Ext), R16.2, R18.2; also elsewhere on the board
unnamed: J14.1 (In), Q1.2 (E), R16.1
unnamed: J15.1 (In), Q2.2 (E), R18.1
unnamed: Q1.3 (C), R15.1
unnamed: Q2.3 (C), R17.1

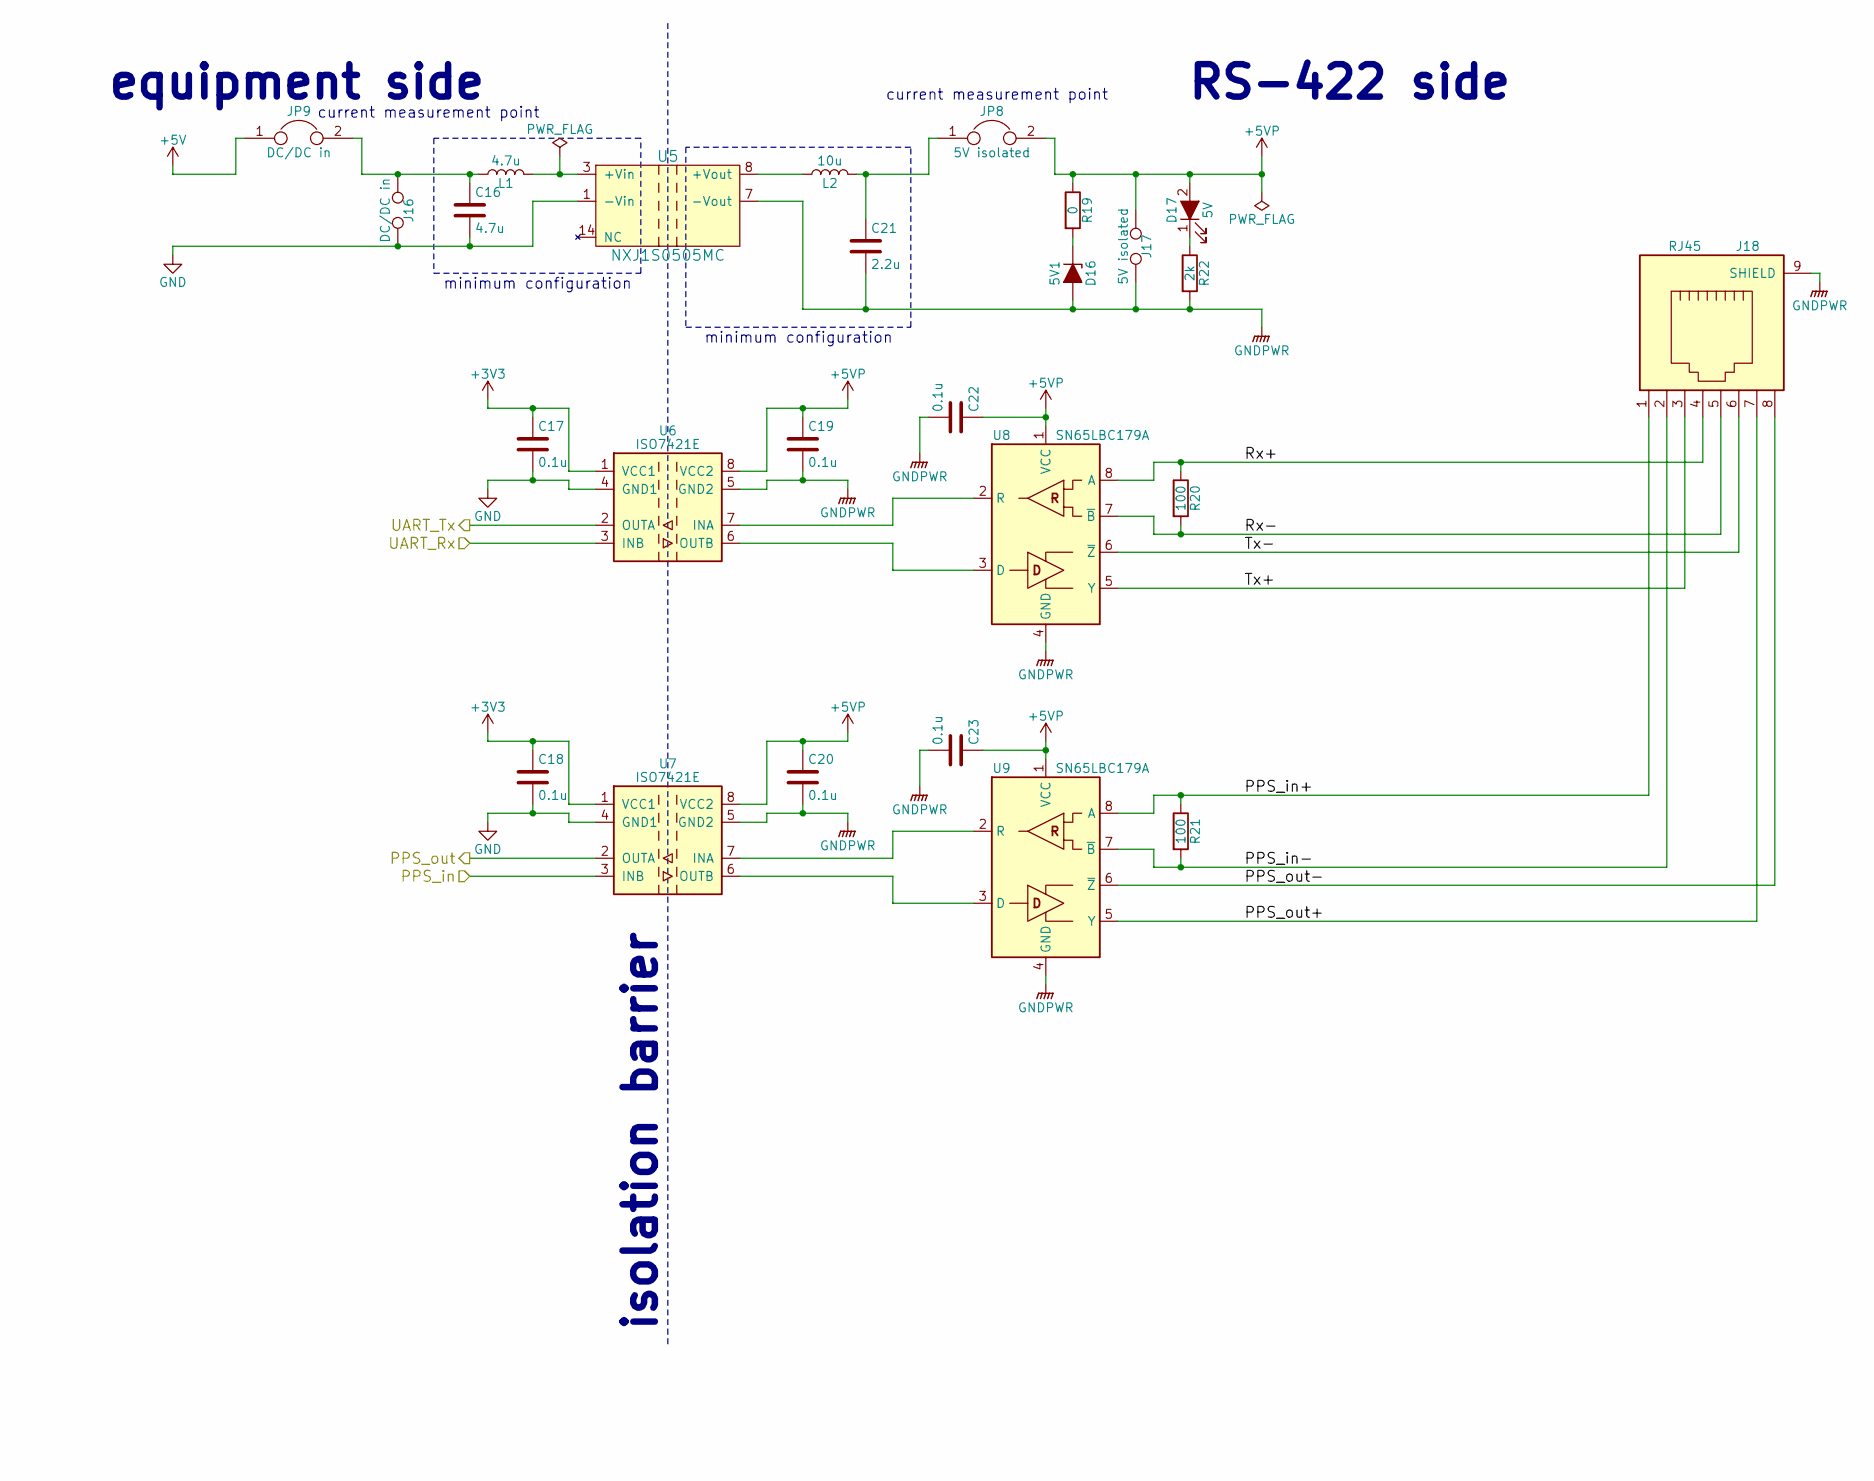
[picture p100: schematic RS-422_interface.sch]

Parts:
C16: 4.7u; 0805_2012
C17, C18, C19, C20, C22, C23: 0.1u; 0805_2012
C21: 2.2u; 0805_2012
D16: 5V1; D_MiniMELF
D17: 5V; 0805_2012; Part# FYLS-0805UBC
J16: DC/DC in; 2P_2.54_SMD
J17: 5V isolated; 2P_2.54_SMD
J18: RJ45; 8P8C_SMD; Part# RJCSE-5380-01; Farnell 2533494
JP8: 5V isolated; 2P_2.54_SMD
JP9: DC/DC in; 2P_2.54_SMD
L1: 4.7u; L_Taiyo-Yuden_NR-24xx_HandSoldering; Part# NRH2410T 4R7MN
L2: 10u; Bourns_SDR0302_Series; Part# SDR0302-100ML
R19: 0; 0805_2012
R20, R21: 100; 0805_2012
R22: 2k; 0805_2012
U5: NXJ1S0505MC; muRata_NXJ1-Series
U6, U7: ISO7421E; SOIC-8
U8, U9: SN65LBC179A; SOIC-8

Connections:
+3V3: C17.1, C18.1, U6.1 (VCC1), U7.1 (VCC1); also elsewhere on the board
+5V: JP9.1; also elsewhere on the board
+5VP: C19.1, C20.1, C22.1, C23.1, D17.2 (A), J17.1, JP8.2, R19.1, U6.8 (VCC2), U7.8 (VCC2), U8.1 (VCC), U9.1 (VCC)
/50-Ohm PPS/PPS_direct: U7.3 (INB); also elsewhere on the board
/50-Ohm PPS/PPS_feedback: U7.2 (OUTA); also elsewhere on the board
/RS-422 interface/PPS_in+: J18.1, R21.1, U9.8 (A)
/RS-422 interface/PPS_in-: J18.2, R21.2, U9.7 (~B)
/RS-422 interface/PPS_out+: J18.7, U9.5 (Y)
/RS-422 interface/PPS_out-: J18.8, U9.6 (~Z)
/RS-422 interface/Rx+: J18.4, R20.1, U8.8 (A)
/RS-422 interface/Rx-: J18.5, R20.2, U8.7 (~B)
/RS-422 interface/Tx+: J18.3, U8.5 (Y)
/RS-422 interface/Tx-: J18.6, U8.6 (~Z)
/debugging LEDs/LED_Rx_line: U6.2 (OUTA); also elsewhere on the board
/debugging LEDs/LED_Tx_line: U6.3 (INB); also elsewhere on the board
GND: C16.2, C17.2, C18.2, J16.2, U5.1 (-Vin), U6.4 (GND1), U7.4 (GND1); also elsewhere on the board
GNDPWR: C19.2, C20.2, C21.2, C22.2, C23.2, D16.2 (A), J17.2, J18.9 (SHIELD), R22.2, U5.7 (-Vout), U6.5 (GND2), U7.5 (GND2), U8.4 (GND), U9.4 (GND)
unnamed: C16.1, J16.1, JP9.2, L1.2
unnamed: C21.1, JP8.1, L2.1
unnamed: D16.1 (K), R19.2
unnamed: D17.1 (K), R22.1
unnamed: L1.1, U5.3 (+Vin)
unnamed: L2.2, U5.8 (+Vout)
unnamed: U6.6 (OUTB), U8.3 (D)
unnamed: U6.7 (INA), U8.2 (R)
unnamed: U7.6 (OUTB), U9.3 (D)
unnamed: U7.7 (INA), U9.2 (R)

Notes on the sheet:
isolation barrier
equipment side
RS-422 side
current measurement point
minimum configuration

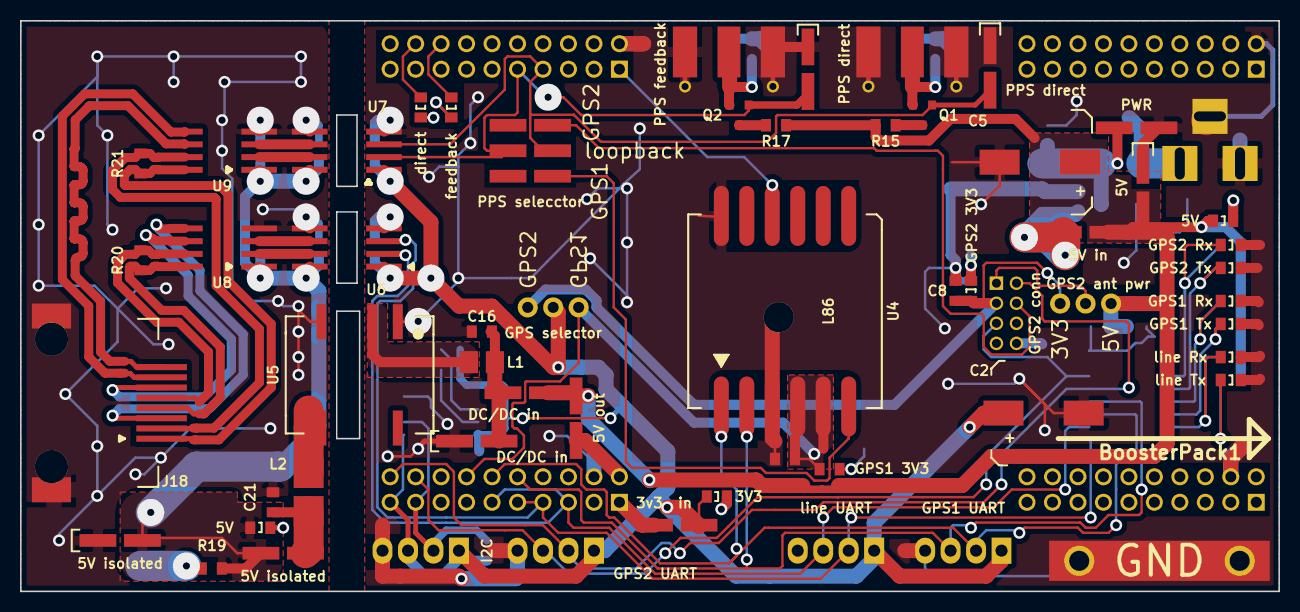
[picture p101: board interfacer.kicad_pcb from above]

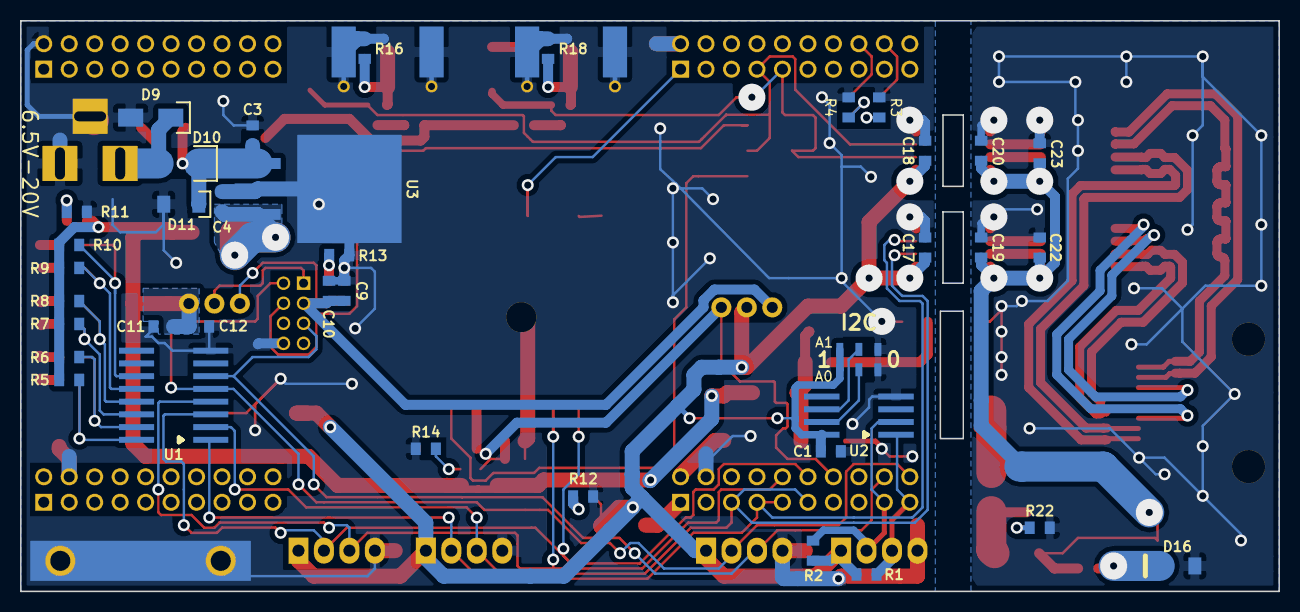
[picture p102: board interfacer.kicad_pcb from below]

Board: 2 copper layers, 125.5 x 56.9 mm, 103 parts (43 on the bottom side), 64 nets.
