aderhol/Clock_Synchronization/Interface/Software/Sync_Interface/latency.c

#include <stdint.h>
#include <stdlib.h>
#include <stdbool.h>
#include <stdio.h>
#include "latency.h"
#include "inc/hw_memmap.h"
#include "inc/hw_ints.h"    //interrupt defines (eg. INT_UART0)
#include "driverlib/timer.h"    //timer
#include "driverlib/interrupt.h"    //interrupt API
#include "driverlib/pin_map.h"  //pin names
#include "driverlib/gpio.h" //GPIO
#include "driverlib/sysctl.h" //System Control
#include "uart_io.h"
#include "i2c_io.h"
#include "pps_leds.h"

extern void InterruptConfigFaultISR(const uint8_t*);
extern uint32_t SYS_CLK_FREQ_ACTUAL;

static char stringBuilder[101];

typedef struct{
    double avrg90;
    double avrg500;
    double avrg1000;
    double data[1001];
    int_fast16_t oldest;
    int_fast16_t write;
    int_fast16_t count;
}RollingAverage;

#define INPUT_CAPTURE_TIMER_WIDTH 16777216 //24 bit wide -> 2^24 = 16,777,216
#define INPUT_CAPTURE_CLOCK_FREQUENCY SYS_CLK_FREQ_ACTUAL
static int32_t offset = 0, timestamp = -1;
static bool measuring = true;
static RollingAverage rollingAverage = {0, 0, 0, {}, 0, 0, 0};

void measureLatency(bool cmnd)
{
    measuring = cmnd;
}

//overflow
void ISR_TIMER0_A(void)
{
    uint32_t callers = TimerIntStatus(TIMER0_BASE, true);   //determines what triggered the interrupt
    TimerIntClear(TIMER0_BASE, callers);    //clears the interrupt flags

    if(callers & TIMER_TIMA_TIMEOUT) { //timer timeout
        if(timestamp != -1) {  //edge on A captured
            if(offset) { //an overflow already occurred
                timestamp = -1;
                offset = 0;
                UARTPrint(UART0_BASE, "\r\n> ERROR: timeout\r\n\r\n");
            }
            else
                offset += INPUT_CAPTURE_TIMER_WIDTH;
        }
        else
            TimerIntClear(TIMER2_BASE, TIMER_CAPA_EVENT & TIMER_CAPB_EVENT);    //prevents the usage of a B event which occurred before the captured A and before the overflow
    }
    else {
        sprintf(stringBuilder, "TIMER0 unexpected interrupt: 0x%X", callers);
        InterruptConfigFaultISR(stringBuilder); //enters fault handler
    }
    if(callers - TIMER_TIMA_TIMEOUT) {  //unexpected interrupt?
        sprintf(stringBuilder, "TIMER0 unexpected interrupt: 0x%X", callers);
        InterruptConfigFaultISR(stringBuilder); //enters fault handler
    }
}

//non-delayed input
void ISR_TIMER2_A(void)
{
    uint32_t callers = TimerIntStatus(TIMER2_BASE, true) & (~TIMER_CAPB_EVENT);   //determines what triggered the interrupt
    TimerIntClear(TIMER2_BASE, callers);    //clears the interrupt flags

    if(callers & TIMER_CAPA_EVENT){  //expected interrupt?
        //UARTPrint(UART0_BASE, "\r\n----------\r\n");
        //if new edge was captured
        if(measuring)
            if(timestamp == -1)
                timestamp = TimerValueGet(TIMER2_BASE, TIMER_A);
            else {
                timestamp = -1;
                offset = 0;
                UARTPrint(UART0_BASE, "\r\n> ERROR: missed edge on B\r\n\r\n");
            }
        PPSDirectkReceived();
    }
    else {
        sprintf(stringBuilder, "TIMER A unexpected interrupt: 0x%X", callers);
        InterruptConfigFaultISR(stringBuilder); //enters fault handler
    }
    if(callers - TIMER_CAPA_EVENT) {  //unexpected interrupt?
        sprintf(stringBuilder, "TIMER A unexpected interrupt: 0x%X", callers);
        InterruptConfigFaultISR(stringBuilder); //enters fault handler
    }
}

//delayed input
void ISR_TIMER2_B(void)
{
    uint32_t callers = TimerIntStatus(TIMER2_BASE, true) & (~TIMER_CAPA_EVENT);   //determines what triggered the interrupt
    TimerIntClear(TIMER2_BASE, callers);    //clears the interrupt flags

    if(callers & TIMER_CAPB_EVENT){  //expected interrupt?
        if(measuring)
            if(timestamp == -1) {
                timestamp = -1;
                offset = 0;
                UARTPrint(UART0_BASE, "\r\n> ERROR: missed edge on A\r\n\r\n");
            }
            else {
                uint32_t timestampB = TimerValueGet(TIMER2_BASE, TIMER_B); //saves timestamp
                if(timestampB + offset > timestamp) {   //checks if B has been captured after A
                    uint8_t cheksum = 0x25/*0x4F*/, out[100] = {/*'\r', '\n', '>', '>', '>', */'$', 'G', 'P', 'I', 'N', 'F', ',', 'D', 'E', 'L', 'A', 'Y', '='};
                    uint_fast8_t outCount = 13/*18*/, ch;
                    double num = ((double)(offset + timestampB - timestamp)) * (1000000000.0 / INPUT_CAPTURE_CLOCK_FREQUENCY);

                    //<rolling average>
                    if(num > 0 && num < 1000000) {      //if the measured date is plausible (aka not a glitch)
                        rollingAverage.data[rollingAverage.write] = num;
                        rollingAverage.write = (rollingAverage.write + 1) % 1001;
                        rollingAverage.count++;
                    }
                    if(rollingAverage.count == 1001) {
                        rollingAverage.oldest = (rollingAverage.oldest + 1) % 1001;
                        rollingAverage.count--;
                    }
                    if(rollingAverage.count >= 1000) {
                        double sum = 0, c = 0;
                        int_fast16_t index = rollingAverage.oldest;
                        while(index != rollingAverage.write) {
                            double y = rollingAverage.data[index] - c;
                            double preSum = sum + y;
                            c = preSum - sum - y;
                            sum = preSum;
                            index = (index + 1) % 1001;
                        }
                        rollingAverage.avrg1000 = sum / 1000;
                    }
                    if(rollingAverage.count >= 90) {
                        double sum = 0, c = 0;
                        int_fast16_t index = (1001 + rollingAverage.write - 90) % 1001;
                        while(index != rollingAverage.write) {
                            double y = rollingAverage.data[index] - c;
                            double preSum = sum + y;
                            c = preSum - sum - y;
                            sum = preSum;
                            index = (index + 1) % 1001;
                        }
                        rollingAverage.avrg90 = sum / 90;
                    }
                    if(rollingAverage.count >= 500) {
                        double sum = 0, c = 0;
                        int_fast16_t index = (1001 + rollingAverage.write - 500) % 1001;
                        while(index != rollingAverage.write) {
                            double y = rollingAverage.data[index] - c;
                            double preSum = sum + y;
                            c = preSum - sum - y;
                            sum = preSum;
                            index = (index + 1) % 1001;
                        }
                        rollingAverage.avrg500 = sum / 500;
                    }

                    /*rollingAverage.data[rollingAverage.write] = num;
                    rollingAverage.write = (rollingAverage.write + 1) % 1001;
                    rollingAverage.count++;
                    if(rollingAverage.count == 1001) {
                        rollingAverage.avrg1000 -= rollingAverage.data[rollingAverage.oldest] / 1000;
                        rollingAverage.oldest = (rollingAverage.oldest + 1) % 1001;
                        rollingAverage.count--;
                    }
                    if(rollingAverage.count > 90) {
                        rollingAverage.avrg90 -= rollingAverage.data[(1001 + rollingAverage.write - (90 + 1)) % 1001] / 90;
                    }
                    if(rollingAverage.count > 500) {
                        rollingAverage.avrg500 -= rollingAverage.data[(1001 + rollingAverage.write - (500 + 1)) % 1001] / 500;
                    }
                    rollingAverage.avrg90 += num / 90;
                    rollingAverage.avrg500 += num / 500;
                    rollingAverage.avrg1000 += num / 1000;*/
                    //</rolling average>

                    uint32_t wholePart = (uint32_t)num;
                    uint8_t fractionPart = ((num - wholePart) * 100) + 0.5;
                    wholePart += fractionPart / 100;
                    uint8_t digits[11];
                    int_fast8_t count = 0;
                    do {
                        digits[count++] = '0' + (wholePart % 10);
                        wholePart /= 10;
                    }while(wholePart);
                    for(count--; count >= 0; count--) {
                        out[outCount++] = digits[count];
                        cheksum ^= digits[count];
                    }
                    out[outCount++] = '.';
                    ch = '0' + ((fractionPart / 10) % 10);
                    out[outCount++] = ch;
                    cheksum ^= ch;
                    ch = '0' + (fractionPart % 10);
                    out[outCount++] = ch;
                    cheksum ^= ch;
                    out[outCount++] = ',';


                    out[outCount++] = 'A';
                    out[outCount++] = '9';
                    out[outCount++] = '0';
                    out[outCount++] = '=';
                    if(rollingAverage.count >= 90) {
                        num = rollingAverage.avrg90;
                        wholePart = (uint32_t)num;
                        fractionPart = ((num - wholePart) * 100) + 0.5;
                        wholePart += fractionPart / 100;
                        count = 0;
                        do {
                            digits[count++] = '0' + (wholePart % 10);
                            wholePart /= 10;
                        }while(wholePart);
                        for(count--; count >= 0; count--) {
                            out[outCount++] = digits[count];
                            cheksum ^= digits[count];
                        }

                        out[outCount++] = '.';
                        cheksum ^= '.';
                        ch = '0' + ((fractionPart / 10) % 10);
                        out[outCount++] = ch;
                        cheksum ^= ch;
                        ch = '0' + (fractionPart % 10);
                        out[outCount++] = ch;
                        cheksum ^= ch;
                    }
                    else {
                        out[outCount++] = '-';
                        cheksum ^= '-';
                    }
                    out[outCount++] = ',';


                    out[outCount++] = 'A';
                    out[outCount++] = '5';
                    out[outCount++] = '0';
                    out[outCount++] = '0';
                    out[outCount++] = '=';
                    if(rollingAverage.count >= 500) {
                        num = rollingAverage.avrg500;
                        wholePart = (uint32_t)num;
                        fractionPart = ((num - wholePart) * 100) + 0.5;
                        wholePart += fractionPart / 100;
                        count = 0;
                        do {
                            digits[count++] = '0' + (wholePart % 10);
                            wholePart /= 10;
                        }while(wholePart);
                        for(count--; count >= 0; count--) {
                            out[outCount++] = digits[count];
                            cheksum ^= digits[count];
                        }

                        out[outCount++] = '.';
                        cheksum ^= '.';
                        ch = '0' + ((fractionPart / 10) % 10);
                        out[outCount++] = ch;
                        cheksum ^= ch;
                        ch = '0' + (fractionPart % 10);
                        out[outCount++] = ch;
                        cheksum ^= ch;
                    }
                    else {
                        out[outCount++] = '-';
                        cheksum ^= '-';
                    }
                    out[outCount++] = ',';


                    out[outCount++] = 'A';
                    out[outCount++] = '1';
                    out[outCount++] = '0';
                    out[outCount++] = '0';
                    out[outCount++] = '0';
                    out[outCount++] = '=';
                    if(rollingAverage.count >= 1000) {
                        num = rollingAverage.avrg1000;
                        wholePart = (uint32_t)num;
                        fractionPart = ((num - wholePart) * 100) + 0.5;
                        wholePart += fractionPart / 100;
                        count = 0;
                        do {
                            digits[count++] = '0' + (wholePart % 10);
                            wholePart /= 10;
                        }while(wholePart);
                        for(count--; count >= 0; count--) {
                            out[outCount++] = digits[count];
                            cheksum ^= digits[count];
                        }

                        out[outCount++] = '.';
                        cheksum ^= '.';
                        ch = '0' + ((fractionPart / 10) % 10);
                        out[outCount++] = ch;
                        cheksum ^= ch;
                        ch = '0' + (fractionPart % 10);
                        out[outCount++] = ch;
                        cheksum ^= ch;
                    }
                    else {
                        out[outCount++] = '-';
                        cheksum ^= '-';
                    }
                    out[outCount++] = ',';


                    out[outCount++] = 'T';
                    out[outCount++] = 'E';
                    out[outCount++] = 'M';
                    out[outCount++] = 'P';
                    out[outCount++] = 'E';
                    out[outCount++] = 'R';
                    out[outCount++] = 'A';
                    out[outCount++] = 'T';
                    out[outCount++] = 'U';
                    out[outCount++] = 'R';
                    out[outCount++] = 'E';
                    out[outCount++] = '=';
                    num = temperature();
                    wholePart = (uint32_t)num;
                    fractionPart = ((num - wholePart) * 10000) + 0.5;
                    wholePart += fractionPart / 10000;
                    count = 0;
                    do {
                        digits[count++] = '0' + (wholePart % 10);
                        wholePart /= 10;
                    }while(wholePart);
                    for(count--; count >= 0; count--) {
                        out[outCount++] = digits[count];
                        cheksum ^= digits[count];
                    }

                    out[outCount++] = '.';
                    ch = '0' + ((fractionPart / 1000) % 10);
                    out[outCount++] = ch;
                    cheksum ^= ch;
                    ch = '0' + ((fractionPart / 100) % 10);
                    out[outCount++] = ch;
                    cheksum ^= ch;
                    ch = '0' + ((fractionPart / 10) % 10);
                    out[outCount++] = ch;
                    cheksum ^= ch;
                    ch = '0' + (fractionPart % 10);
                    out[outCount++] = ch;
                    cheksum ^= ch;

                    out[outCount++] = '*';
                    out[outCount++] = (((cheksum / 16) % 16) <= 9) ? ('0' + ((cheksum / 16) % 16)) : ('A' + (((cheksum / 16) % 16) - 10));
                    out[outCount++] = ((cheksum % 16) <= 9) ? ('0' + (cheksum % 16)) : ('A' + ((cheksum % 16) - 10));
                    out[outCount++] = '\r';
                    out[outCount++] = '\n';
                    /*out[outCount++] = '\r';
                    out[outCount++] = '\n';*/
                    out[outCount] = '\0';
                    UARTPrint(UART0_BASE, out);             //USB
                    UARTPrint(UART6_BASE, out);             //line

                    timestamp = -1;
                    offset = 0;
                    //measuring--;
                }
                else {
                    timestamp = -1;
                    offset = 0;
                    UARTPrint(UART0_BASE, "\r\n> ERROR: B predates A\r\n\r\n");
                    TimerIntClear(TIMER2_BASE, TIMER_CAPA_EVENT & TIMER_CAPB_EVENT);
                }
            }
        PPSFeedbackReceived();
    }
    else {
        sprintf(stringBuilder, "TIMER B unexpected interrupt 1: callers->0x%X", callers);
        InterruptConfigFaultISR(stringBuilder); //enters fault handler
    }
    if(callers - TIMER_CAPB_EVENT) {  //unexpected interrupt?
        sprintf(stringBuilder, "TIMER B unexpected interrupt 2: 0x%X", callers);
        InterruptConfigFaultISR(stringBuilder); //enters fault handler
    }
}

void latencyInit()
{
    SysCtlPeripheralEnable(SYSCTL_PERIPH_GPIOM);    //enables GPIOA
    //TIMER0 is needed, because timers configured for input capture doesn't raise overflow interrupts
    SysCtlPeripheralEnable(SYSCTL_PERIPH_TIMER0);   //enables TIMER 0, which needs to enabled in order to make GPTMSYNC accessible
    SysCtlPeripheralEnable(SYSCTL_PERIPH_TIMER2);   //enables TIMER 2

    //waits until peripheries are ready
    while(!SysCtlPeripheralReady(SYSCTL_PERIPH_TIMER2));

    //configures timers for two-signal edge-separation
    GPIOPinConfigure(GPIO_PM0_T2CCP0);   //sets PM0 as the input capture input for TIMER2 TIMER A
    GPIOPinConfigure(GPIO_PM1_T2CCP1);   //sets PM1 as the input capture input for TIMER2 TIMER B
    GPIOPinTypeTimer(GPIO_PORTM_BASE, GPIO_PIN_0 | GPIO_PIN_1); //configures the pins
    TimerClockSourceSet(TIMER0_BASE, TIMER_CLOCK_SYSTEM);  //TIMER0 is clocked from the system clock
    TimerClockSourceSet(TIMER2_BASE, TIMER_CLOCK_SYSTEM);  //TIMER2 is clocked from the system clock
    TimerConfigure(TIMER0_BASE, (TIMER_CFG_SPLIT_PAIR | TIMER_CFG_A_PERIODIC_UP)); //configures TIMER0
    TimerConfigure(TIMER2_BASE, (TIMER_CFG_SPLIT_PAIR | TIMER_CFG_A_CAP_TIME_UP | TIMER_CFG_B_CAP_TIME_UP)); //configures TIMER2 TIMER A/B
    TimerControlEvent(TIMER2_BASE, TIMER_A, TIMER_EVENT_POS_EDGE);   //configures Timer A to capture rising edges
    TimerControlEvent(TIMER2_BASE, TIMER_B, TIMER_EVENT_POS_EDGE);   //configures Timer B to capture rising edges
    TimerIntEnable(TIMER0_BASE, TIMER_TIMA_TIMEOUT); //enables overflow interrupt on TIMER0 A
    TimerIntEnable(TIMER2_BASE, (TIMER_CAPB_EVENT | TIMER_CAPA_EVENT));   //enables interrupt for edge capture on TIMER2 TIMER A/B and for overflow on TIMER2 TIMER A
    TimerLoadSet(TIMER0_BASE, TIMER_A, 0xFFFF);
    TimerPrescaleSet(TIMER0_BASE, TIMER_A, 0xFF);
    TimerLoadSet(TIMER2_BASE, TIMER_BOTH, 0xFFFF);
    TimerPrescaleSet(TIMER2_BASE, TIMER_BOTH, 0xFF);
    TimerEnable(TIMER2_BASE, TIMER_BOTH);
    TimerEnable(TIMER0_BASE, TIMER_A);
    TimerSynchronize(TIMER0_BASE, (TIMER_0A_SYNC | TIMER_2A_SYNC | TIMER_2B_SYNC));  //Synchronizes TIMER0 A and TIMER2 A and B with each other
    IntEnable(INT_TIMER0A);
    IntEnable(INT_TIMER2A);
    IntEnable(INT_TIMER2B);
}

void resetAverages(void)
{
    rollingAverage.avrg90 = 0;
    rollingAverage.avrg500 = 0;
    rollingAverage.avrg1000 = 0;
    rollingAverage.count = 0;
    rollingAverage.oldest = 0;
    rollingAverage.write = 0;
}
