aderhol/Clock_Synchronization/Interface/Software/Sync_Interface/command.c

#include <stdint.h>
#include <stdbool.h>
#include <errno.h>
#include "command.h"
#include <string.h>
#include <stdbool.h>
#include <stdlib.h>
#include <ctype.h>
#include "uart_io.h"
#include "latency.h"
#include "i2c_io.h"

extern void pulse(void);
extern void InterruptConfigFaultISR(const uint8_t*);
extern uint32_t GPS_base;

#define COMMAND_BUFFER_SIZE 10

const static char* commands[] = {"forward", "help", "mode", "reset","sitrep", "temp", "view"};
const static char* usage[] = {" forward to [device] [message]\r\n                     >[command]"," help", " mode [gps1/gps2/loopback]", " reset averages", " sitrep", " temp", " view [on/off] [device]"};
enum {FORWARD, HELP, MODE, RESET, SITREP, TEMP, VIEW};

static void getCommands(uint32_t);
static uint8_t* FetchCommand(void);

static uint8_t buffer[COMMAND_BUFFER_SIZE][101], readPtr = 0, writePtr = 0;
static bool empty = true;

static inline bool push(uint8_t* command)
{
    if(readPtr != writePtr || empty){
        strcpy(buffer[writePtr], command);
        writePtr = (writePtr + 1) % COMMAND_BUFFER_SIZE;
        empty = false;
        return true;
    }
    else
        return false;
}

static inline const uint8_t* pop()
{
    if (empty)
        return NULL;
    else {
        uint8_t* temp = buffer[readPtr];
        readPtr = (readPtr + 1) % COMMAND_BUFFER_SIZE;
        if(readPtr == writePtr)
            empty = true;
        return temp;
    }
}

static void getCommands(uint32_t base)
{
    static uint8_t line[101];
    static uint_fast8_t count = 0;

    while(uartHasData(base)){
        uint_fast8_t ch = UARTGetch(base);
        if(ch == '\n'){
            if(line[count - 1] == '\r')
                line[count - 1] = '\0';
            else
                line[count] = '\0';

            count = 0;

            push(line);
        }
        else
            if(ch != '\0') {
                if(count == 100)
                    InterruptConfigFaultISR("Command overrun");
                if(ch == '\b')
                    count = (count == 0) ? 0 : count - 1;
                else
                    line[count++] = ch;
            }
    }
}

static inline  uint8_t* FetchCommand(void) {
    static uint8_t holster[101];
    const uint8_t* temp = pop();
    if(temp == NULL)
        return NULL;
    else {
        strcpy(holster, temp);
        return holster;
    }
}

void CommandInterpreter(void)
{
    //read commands
    getCommands(UART0_BASE);

    //execute commands
    uint8_t* command;
    while((command = FetchCommand()) != NULL)
        execute(command, UART0_BASE);
}

void execute(uint8_t* command_in, uint32_t base) {

    if( command_in[0] == '$') {  //if NMEA message
        UARTPrint(GPS_base, command_in);
        UARTPrint(GPS_base, "\r\n");
        return;
    }

    char* tokens[15];
    char command[101];
    strcpy(command, command_in);
    int_fast8_t count = 0; //number of tokens

    //to lower case (whole command)
    for(tokens[0] = command; *tokens[0] != '\0'; tokens[0]++)
        *tokens[0] = tolower(*tokens[0]);

    //tokenization
    while((tokens[count] = strtok(count ? NULL : command, " \r\n")) != NULL && count < (sizeof(tokens) / sizeof(tokens[0]) - 1))
        count++;
    if(count > 0) {
        if(count == (sizeof(tokens) / sizeof(tokens[0]) - 1) && tokens[count] != NULL && (count++, strtok(NULL, " \r\n") != NULL)) //to much tokens?
            UARTPrint(base, " Invalid command!\r\n");
        else {
            int_fast8_t start = 0, end = sizeof(commands) / sizeof(commands[0]) - 1, cmd = -1;

            //binary search
            do {
                int cmp;
                int_fast8_t ref;

                ref = (start + end) / 2;
                cmp = strcmp(tokens[0], commands[ref]);
                if(cmp == 0)
                    cmd = ref;
                else
                    if(cmp < 0)
                        end = ref - 1;
                    else
                        start = ref + 1;
            }while(cmd == -1 && start <= end);

            if(cmd != -1) {
                switch(cmd) {
                case RESET:
                    if(count == 2){
                        if(strcmp(tokens[1], "averages") == 0){
                            resetAverages();
                        }
                        else{
                            UARTPrint(base, "\r\n Syntax error!\r\n Usage: reset averages\r\n");
                            break;
                        }
                    }
                    else
                        UARTPrint(base, "\r\n Syntax error!\r\n Usage: reset averages\r\n");
                    break;
                case MODE:
                    if(count == 2){
                        if(strcmp(tokens[1], "gps1") == 0){
                            measureLatency(true);
                            GPS_base = UART4_BASE;
                        }
                        else if(strcmp(tokens[1], "gps2") == 0){
                            measureLatency(true);
                            GPS_base = UART3_BASE;
                        }
                        else if(strcmp(tokens[1], "loopback") == 0){
                            measureLatency(false);
                        }
                        else{
                            UARTPrint(base, "\r\nInvalid mode.\r\n");
                            break;
                        }
                    }
                    else
                        UARTPrint(base, "\r\n Syntax error!\r\n Usage: mode [gps1/gps2/loopback]\r\n");
                    break;
                case FORWARD:
                    if(count > 3 && (strcmp(tokens[1], "to") == 0)){
                        if(strcmp(tokens[2], "line") == 0){
                            UARTPrint(UART6_BASE, command_in + 16); //+16, so that the front gets cut off
                            UARTPrint(UART6_BASE, "\r\n");
                        }
                        else{
                            UARTPrint(base, "\r\nUnkonwn device.\r\n");
                            break;
                        }
                        UARTPrint(base, "\r\nMessage forwarded to ");
                        UARTPrint(base, tokens[2]);
                        UARTPrint(base, ".\r\n");
                    }
                    else
                        UARTPrint(base, "\r\n Syntax error!\r\n Usage: forward to [device] [message]\r\n");
                    break;
                case VIEW:
                    if(count == 3){
                        bool comnd;
                        if(strcmp(tokens[1], "on") == 0)
                            comnd = true;
                        else if(strcmp(tokens[1], "off") == 0)
                            comnd = false;
                        else{
                            UARTPrint(base, "\r\n Syntax error!\r\n Usage: view [on/off] [device]\r\n");
                            break;
                        }
                        if(strcmp(tokens[2], "gps") == 0){
                            show_gps = comnd;
                        }
                        else if(strcmp(tokens[2], "line") == 0){
                            show_line = comnd;
                        }
                        else{
                            UARTPrint(base, "\r\nUnkonwn device.\r\n");
                            break;
                        }
                        UARTPrint(base, "\r\nView for ");
                        UARTPrint(base, tokens[2]);
                        UARTPrint(base, " is now ");
                        UARTPrint(base, tokens[1]);
                        UARTPrint(base, ".\r\n");
                    }
                    else
                        UARTPrint(base, "\r\n Syntax error!\r\n Usage: view [on/off] [device]\r\n");
                    break;
                case TEMP:{
                    double temp = temperature();
                    UARTPrint(base, " ***\r\n The temperature is ");
                    UARTPrint_i32(base, (int32_t)temp);
                    UARTPrint(base, ".");
                    UARTPrint_i32(base, (int32_t)((temp - (int32_t)temp) * 100));
                    UARTPrint(base, "°C.\r\n***\r\n");}
                    break;
                case HELP: //help
                    if(count > 1)
                        UARTPrint(base, "\r\n Syntax error!\r\n Usage: help\r\n");
                    else {
                        UARTPrint(base, "\r\n***********HELP***********\r\n");
                        for(start = 0; start < sizeof(usage) / sizeof(usage[0]); start++) {
                            UARTPrint(base, usage[start]);
                            UARTPrint(base, "\r\n");
                        }
                        UARTPrint(base, "**************************\r\n\r\n");
                    }
                    break;
                case SITREP: //sitrep
                    UARTPrint(base, " Awaiting instructions.\r\n");
                    if(count > 1)
                        UARTPrint(base, "\r\n Syntax error!\r\n Usage: sitrep\r\n");
                    break;
                default:
                    UARTPrint(base, " Unimplemented command!\r\n");
                    break;
                }
            }
            else
                UARTPrint(base, " Invalid command!\r\n");

        }
    }
}
