aderhol/Clock_Synchronization/(commit log)

2017-10-27 silkscreen and solder mask finalization wiring touch-up
    [interfacer-B.Cu.gbr, interfacer-B.Mask.gbr, interfacer-B.SilkS.gbr, interfacer-Edge.Cuts.gbr, interfacer-F.Cu.gbr, interfacer-F.Mask.gbr, interfacer-F.SilkS.gbr, interfacer.drl]
2017-10-29 8P8C, GPS1 gnd pin fix
    [interfacer-B.Cu.gbr, interfacer-B.Mask.gbr, interfacer-B.SilkS.gbr, interfacer-Edge.Cuts.gbr, interfacer-F.Cu.gbr, interfacer-F.Mask.gbr, interfacer-F.SilkS.gbr, interfacer.drl]
2017-11-14 assembly record
    [assembly record.xlsx, interfacer.csv]
2017-11-15 card #1 assembled
    [assembly record.xlsx]
2017-11-15 resistor change for green LEDs
    [assembly record.xlsx]
2017-11-15 antenna power touch-up & green LED resistor value change
    [debugging_LEDs.sch, interfacer.kicad_pcb]
2017-11-15 added pin names to the main connector
    [main_connector.sch]
2017-11-16 temperature sensor (I2C)
2017-11-16 line UART out
    [RS-422_interface.sch, main_connector.sch]
2017-11-17 card#2 partially assembled
    [assembly record.xlsx]
2017-11-19 PPS delay measurement data
    [VirtualBench.csv, scope.CSV, small.csv]
2017-11-20 50 Ohm driver latency measurements
    [T0000ALL.CSV, direct.csv]
2017-11-21 command-over-line, views, and PPS LEDs
2017-11-21 reset & GPS1 inital config (115200 baud, timing product)
    [command.c, main.c, system_tick.c, uart_io.c]
2017-11-21 Revert "reset & GPS1 inital config (115200 baud, timing product)"
    This reverts commit ed776d911817a95cc33cef9cfc96954527a65ba9.
    [command.c, main.c, system_tick.c, uart_io.c]
2017-11-21 MIT 03.104-03.105
    [PicoScope_01.csv, PicoScope_02.csv, PicoScope_03.csv, PicoScope_04.csv, PicoScope_05.csv, PicoScope_06.csv, PicoScope_07.csv, PicoScope_08.csv]
2017-11-21 GPS module, PPS feedback 50 ohm drive, molex connectors
    [assembly record.xlsx, main_connector.sch]
2017-12-22 UART buffer size increase
2017-12-22 card#2 PPS feedback 50 Ohm driver latency measurement
    [T0000ALL.CSV]
2018-02-01 temperature dependence measurements
    [scope.CSV, small.csv]
2018-02-01 117cm round-trip measurement
